thedarknet/defcon24/badge/README.md

Install Dev Env:
* go here:  http://gnuarmeclipse.github.io/ for background and step by step

Basic steps:

* Install eclipse Luna CDT (c++ env)

* add a new market place:  

name: GNU ARM Eclipse Plug-ins
URL: http://gnuarmeclipse.sourceforge.net/updates

You will see the ecplise arm plugin select it and it will install for you.

If you get complaints about missing software I found these links helpful.

* apt-get install gcc-arm-none-eabi (or something close to that)

* apt-get install openocd Or download from to configure openocd in eclipse look here: http://gnuarmeclipse.github.io/debug/openocd/ OR to download new version of openocd:  http://gnuarmeclipse.github.io/openocd/download/

Then close this repo and then import this directory into you're workspace (remeber to uncheck the option to copy all files to your workspace).

Debug configuration:
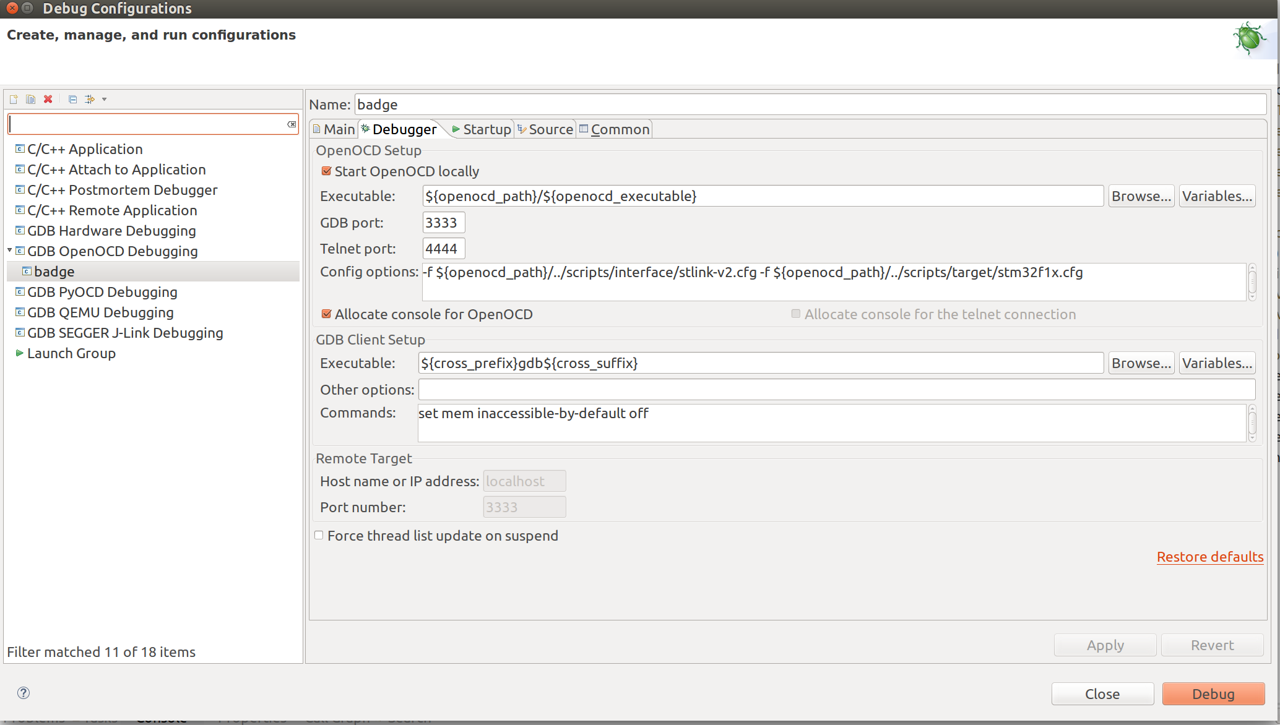
[picture p1: badge/Screenshot from 2016-06-21 22:05:16.png]
Debug Config
