thedarknet/defcon24/badge/hardware/board/README.md

# Badge hardware

	DC24-Darknet_Badge.*		The starting circuit which has both the base and the shield included
	DC24-Darknet_Badge-base.*	The final base board with puzzles in the silk screen
	DC24-Darknet_Badge-shield.*	The final shield board with puzzles in the silk screen

Note to get the boards made at OSH Park, you need to submit the individual boards base and shield. 
The combined file is strictly for the full schematic.
