thedarknet/defcon24/badge/hardware/board/DC24-Darknet_Badge.pdf

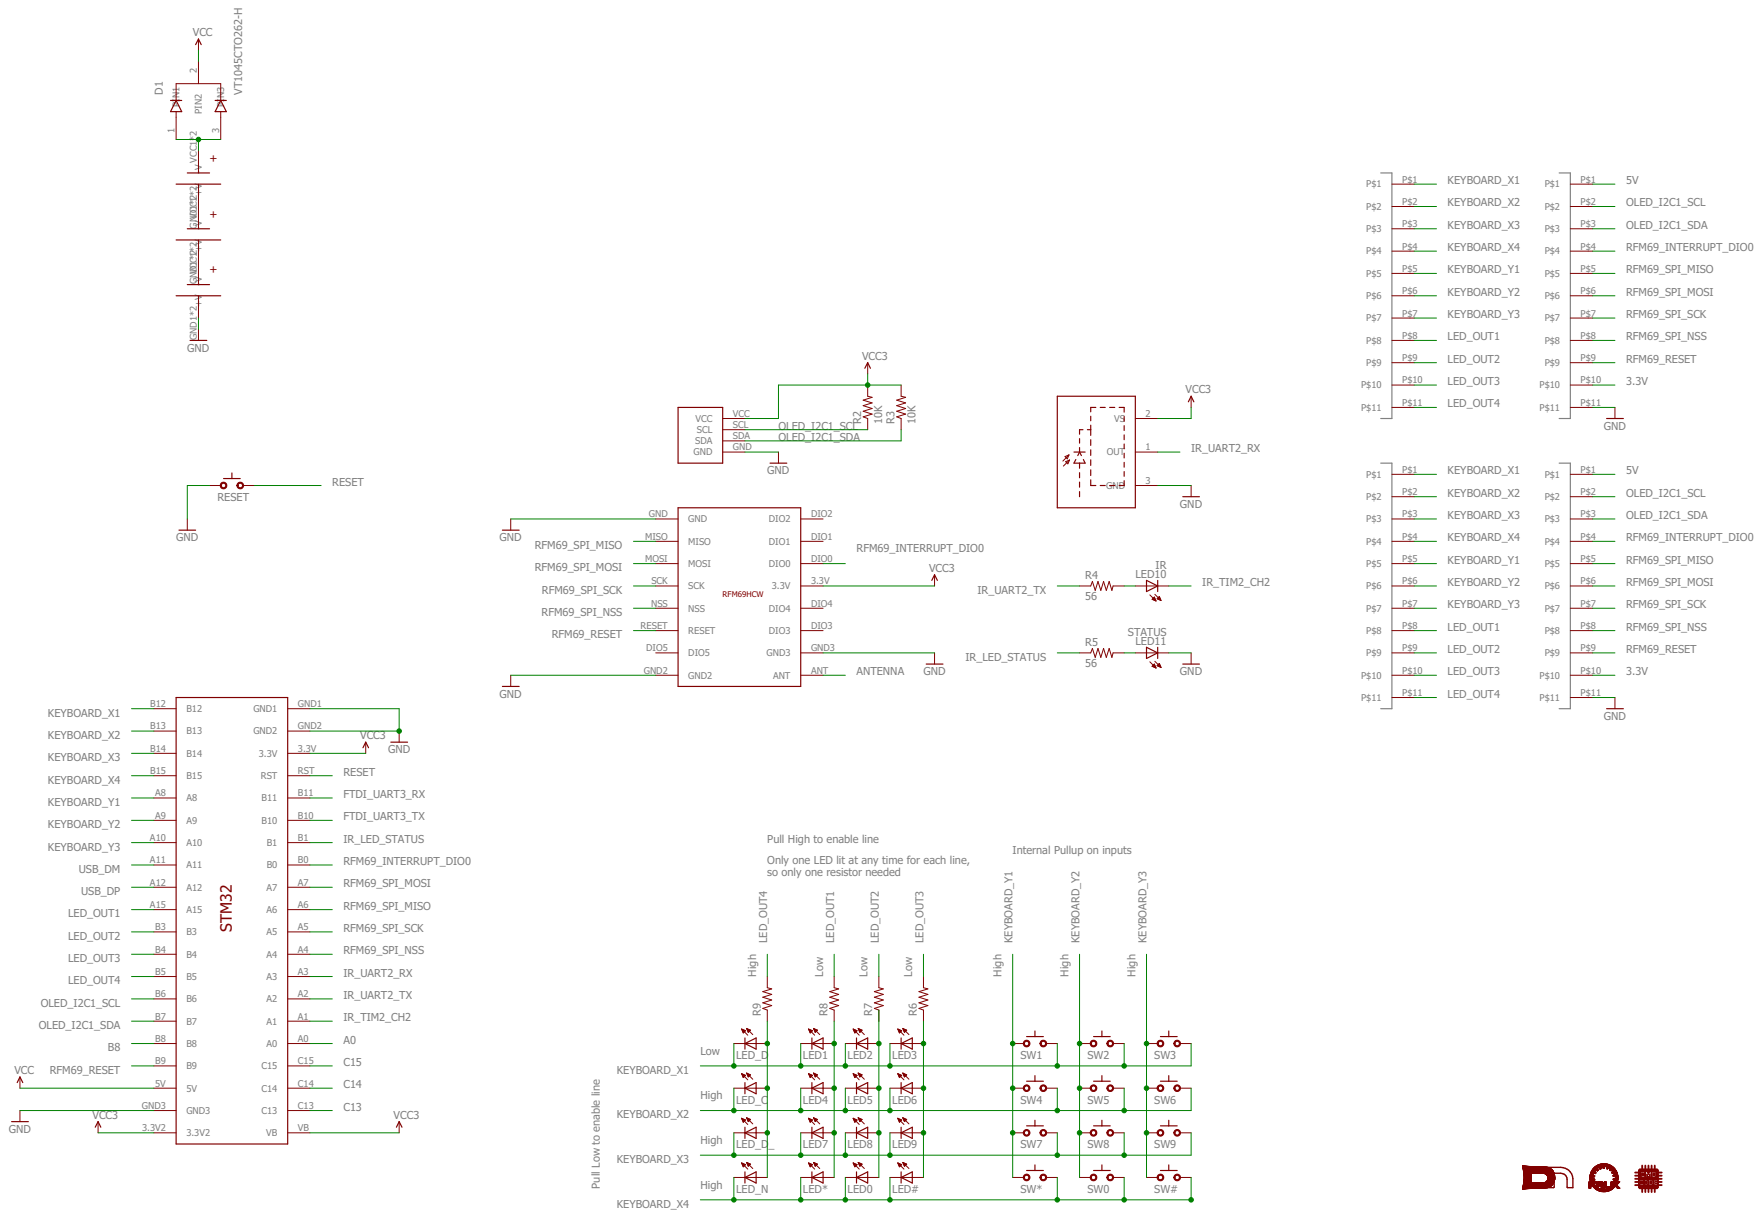
[picture p2: page 1]

Pull High to enable line Only one LED lit at any time for each line, so only one resistor needed

Internal Pullup on inputs

Pull Low to enable line
