thedarknet/defcon24/badge/hardware/board/DC24-Darknet_Badge-base.brd

## EAGLE design badge/hardware/board/DC24-Darknet_Badge-base.brd (2016-08-10)

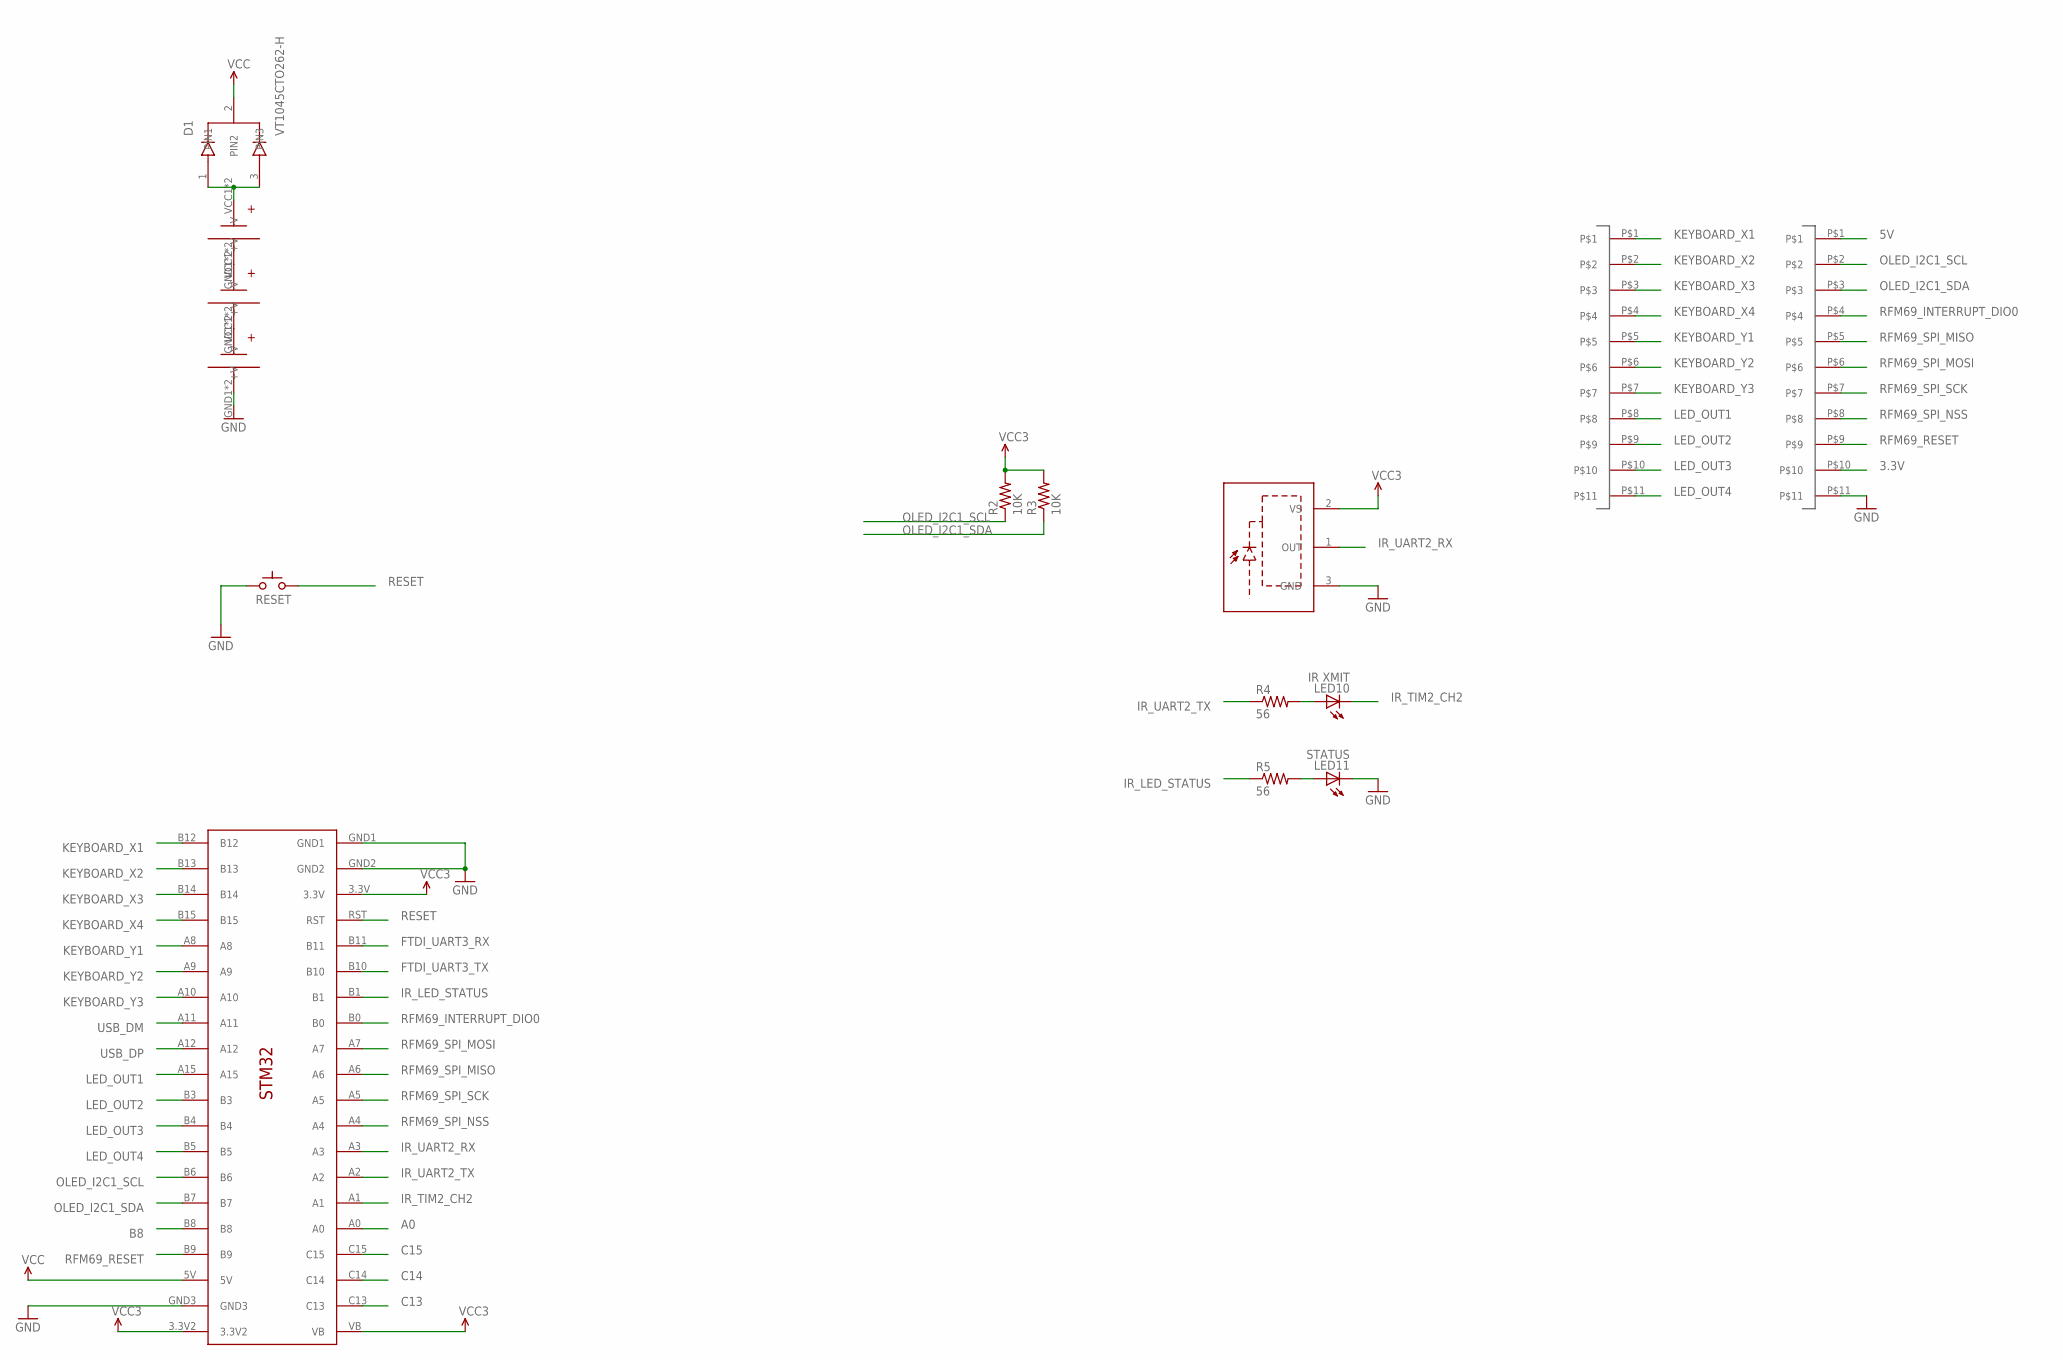
[picture p3: schematic DC24-Darknet_Badge-base.sch]

Parts:
D1: VT1045CTO262-H; TO262-H
LED10: IR XMIT; LED5MM-EDGE
LED11: STATUS; LED5MM-EDGE
R2, R3: 10K; AXIAL-0.3
R4, R5: 56; AXIAL-0.3
RESET: SWITCH_TACTILETACTILE-2PIN-NARROW; TACTILE-2PIN-NARROW
U1: SOP22; IR-MODULE
U$3, U$4, U$5: AAA_BATTERYAAA_BATTERY_CLIP; AAA_BATTERY_CLIP
U$14, U$17: HEADER_11PIN; 1X11
U$15: STM32_DEV_BOARDSTM32_DEV_BOARD; STM32_DEV_BOARD

Connections:
3.3V: R2.P$2 (2), R3.P$2 (2), U1.2 (VS), U$15.3.3V, U$15.3.3V2, U$15.VB, U$17.P$10
5V: D1.2 (PIN2), U$15.5V, U$17.P$1
A0: U$15.A0
B8: U$15.B8
C13: U$15.C13
C14: U$15.C14
C15: U$15.C15
FTDI_UART3_RX: U$15.B11
FTDI_UART3_TX: U$15.B10
GND: LED11.K (C), RESET.P$2 (C), U1.3 (GND), U$5.GND1 (-V), U$5.GND2 (-V), U$15.GND1, U$15.GND2, U$15.GND3, U$17.P$11
IR_LED_STATUS: R5.P$1 (1), U$15.B1
IR_TIM2_CH2: LED10.K (C), U$15.A1
IR_UART2_RX: U1.1 (OUT), U$15.A3
IR_UART2_TX: R4.P$1 (1), U$15.A2
KEYBOARD_X1: U$14.P$1, U$15.B12
KEYBOARD_X2: U$14.P$2, U$15.B13
KEYBOARD_X3: U$14.P$3, U$15.B14
KEYBOARD_X4: U$14.P$4, U$15.B15
KEYBOARD_Y1: U$14.P$5, U$15.A8
KEYBOARD_Y2: U$14.P$6, U$15.A9
KEYBOARD_Y3: U$14.P$7, U$15.A10
LED_OUT1: U$14.P$8, U$15.A15
LED_OUT2: U$14.P$9, U$15.B3
LED_OUT3: U$14.P$10, U$15.B4
LED_OUT4: U$14.P$11, U$15.B5
unnamed: LED10.A, R4.P$2 (2)
unnamed: LED11.A, R5.P$2 (2)
unnamed: D1.1 (PIN1), D1.3 (PIN3), U$3.VCC1 (+V), U$3.VCC2 (+V)
unnamed: U$3.GND1 (-V), U$3.GND2 (-V), U$4.VCC1 (+V), U$4.VCC2 (+V)
unnamed: U$4.GND1 (-V), U$4.GND2 (-V), U$5.VCC1 (+V), U$5.VCC2 (+V)
OLED_I2C1_SCL: R2.P$1 (1), U$15.B6, U$17.P$2
OLED_I2C1_SDA: R3.P$1 (1), U$15.B7, U$17.P$3
RESET: RESET.P$1 (A), U$15.RST
RFM69_INTERRUPT_DIO0: U$15.B0, U$17.P$4
RFM69_RESET: U$15.B9, U$17.P$9
RFM69_SPI_MISO: U$15.A6, U$17.P$5
RFM69_SPI_MOSI: U$15.A7, U$17.P$6
RFM69_SPI_NSS: U$15.A4, U$17.P$8
RFM69_SPI_SCK: U$15.A5, U$17.P$7
USB_DM: U$15.A11
USB_DP: U$15.A12

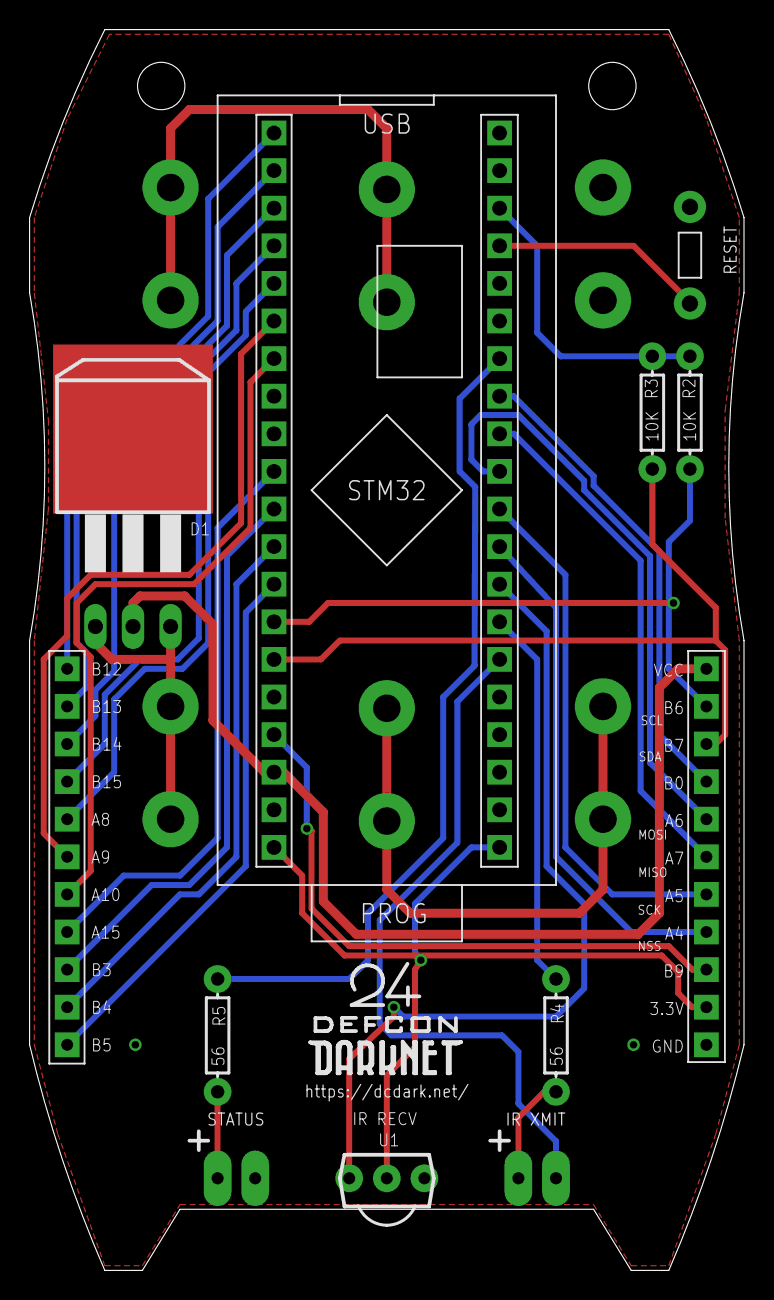
[picture p4: board DC24-Darknet_Badge-base.brd from above]

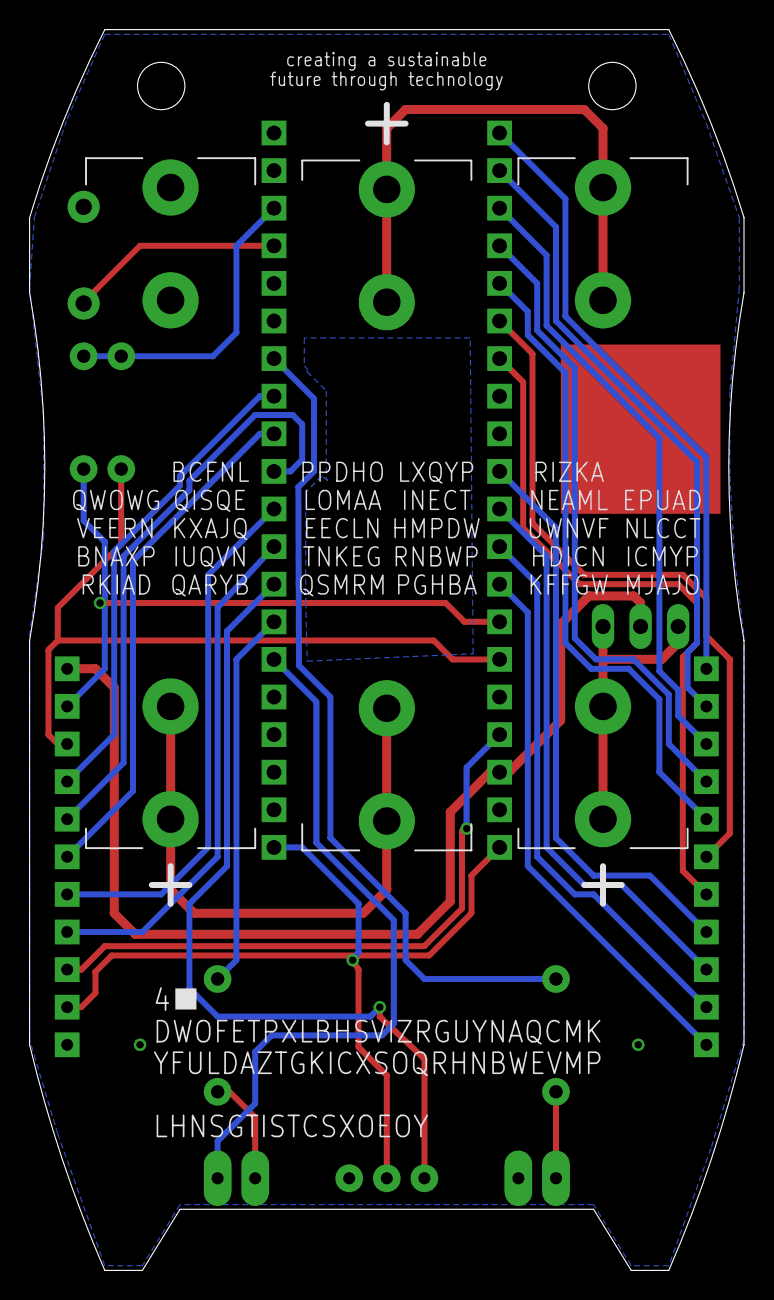
[picture p5: board DC24-Darknet_Badge-base.brd from below]

Board: 2 copper layers, 48.3 x 83.8 mm, 15 parts (3 on the bottom side), 32 nets.
