thedarknet/defcon24/badge/hardware/board/DC24-Darknet_Badge-shield.brd

## EAGLE design badge/hardware/board/DC24-Darknet_Badge-shield.brd (2016-08-08)

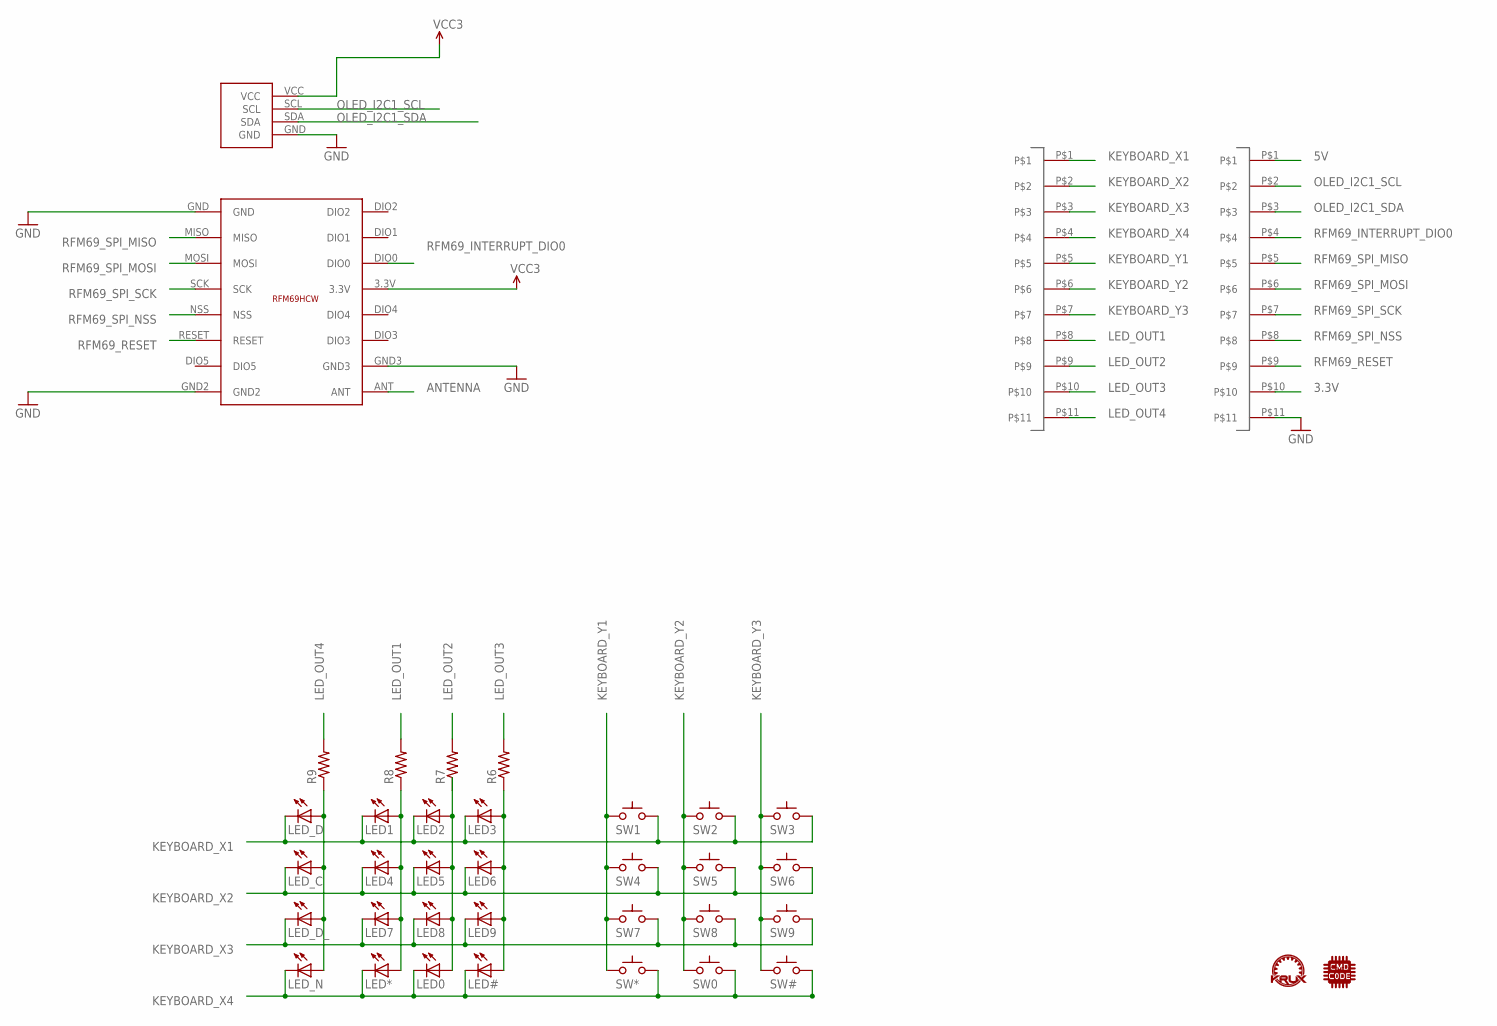
[picture p6: schematic DC24-Darknet_Badge-shield.sch]

Parts:
LED0, LED1, LED2, LED3, LED4, LED5, LED6, LED7, LED8, LED9: LEDREVERSEMOUNT; GULLWING_LED
LED#: LEDREVERSEMOUNT; GULLWING_LED
LED*: LEDREVERSEMOUNT; GULLWING_LED
LED_C: LEDREVERSEMOUNT; GULLWING_LED
LED_D: LEDREVERSEMOUNT; GULLWING_LED
LED_D_: LEDREVERSEMOUNT; GULLWING_LED
LED_N: LEDREVERSEMOUNT; GULLWING_LED
R6, R7, R8, R9: RESISTOR1206; 1206
SW0, SW1, SW2, SW3, SW4, SW5, SW6, SW7, SW8, SW9: SWITCH_TACTILETACTILE-2PIN-NARROW; TACTILE-2PIN-NARROW
SW#: SWITCH_TACTILETACTILE-2PIN-NARROW; TACTILE-2PIN-NARROW
SW*: SWITCH_TACTILETACTILE-2PIN-NARROW; TACTILE-2PIN-NARROW
U$1: I2C_0.96_OLEDOLED; I2C_0.96_OLED
U$2: RFM69HCWRFN69HCWSMD; 16PIN-PCB-SMD
U$6, U$13: HEADER_11PIN; 1X11
U$21: KRUX_LOGO
U$23: CMD_C0DE_LOGO

Connections:
3.3V: U$1.VCC, U$2.3.3V, U$13.P$10
5V: U$13.P$1
ANTENNA: U$2.ANT
GND: U$1.GND, U$2.GND, U$2.GND2, U$2.GND3, U$13.P$11
KEYBOARD_X1: LED1.C, LED2.C, LED3.C, LED_D.C, SW1.P$1 (A), SW2.P$1 (A), SW3.P$1 (A), U$6.P$1
KEYBOARD_X2: LED4.C, LED5.C, LED6.C, LED_C.C, SW4.P$1 (A), SW5.P$1 (A), SW6.P$1 (A), U$6.P$2
KEYBOARD_X3: LED7.C, LED8.C, LED9.C, LED_D_.C, SW7.P$1 (A), SW8.P$1 (A), SW9.P$1 (A), U$6.P$3
KEYBOARD_X4: LED0.C, LED#.C, LED*.C, LED_N.C, SW0.P$1 (A), SW#.P$1 (A), SW*.P$1 (A), U$6.P$4
KEYBOARD_Y1: SW1.P$2 (C), SW4.P$2 (C), SW7.P$2 (C), SW*.P$2 (C), U$6.P$5
KEYBOARD_Y2: SW0.P$2 (C), SW2.P$2 (C), SW5.P$2 (C), SW8.P$2 (C), U$6.P$6
KEYBOARD_Y3: SW3.P$2 (C), SW6.P$2 (C), SW9.P$2 (C), SW#.P$2 (C), U$6.P$7
LED_OUT1: R8.2, U$6.P$8
LED_OUT2: R7.2, U$6.P$9
LED_OUT3: R6.2, U$6.P$10
LED_OUT4: R9.2, U$6.P$11
unnamed: LED3.A, LED6.A, LED9.A, LED#.A, R6.1
unnamed: LED0.A, LED2.A, LED5.A, LED8.A, R7.1
unnamed: LED1.A, LED4.A, LED7.A, LED*.A, R8.1
unnamed: LED_C.A, LED_D.A, LED_D_.A, LED_N.A, R9.1
OLED_I2C1_SCL: U$1.SCL, U$13.P$2
OLED_I2C1_SDA: U$1.SDA, U$13.P$3
RFM69_INTERRUPT_DIO0: U$2.DIO0, U$13.P$4
RFM69_RESET: U$2.RESET, U$13.P$9
RFM69_SPI_MISO: U$2.MISO, U$13.P$5
RFM69_SPI_MOSI: U$2.MOSI, U$13.P$6
RFM69_SPI_NSS: U$2.NSS, U$13.P$8
RFM69_SPI_SCK: U$2.SCK, U$13.P$7

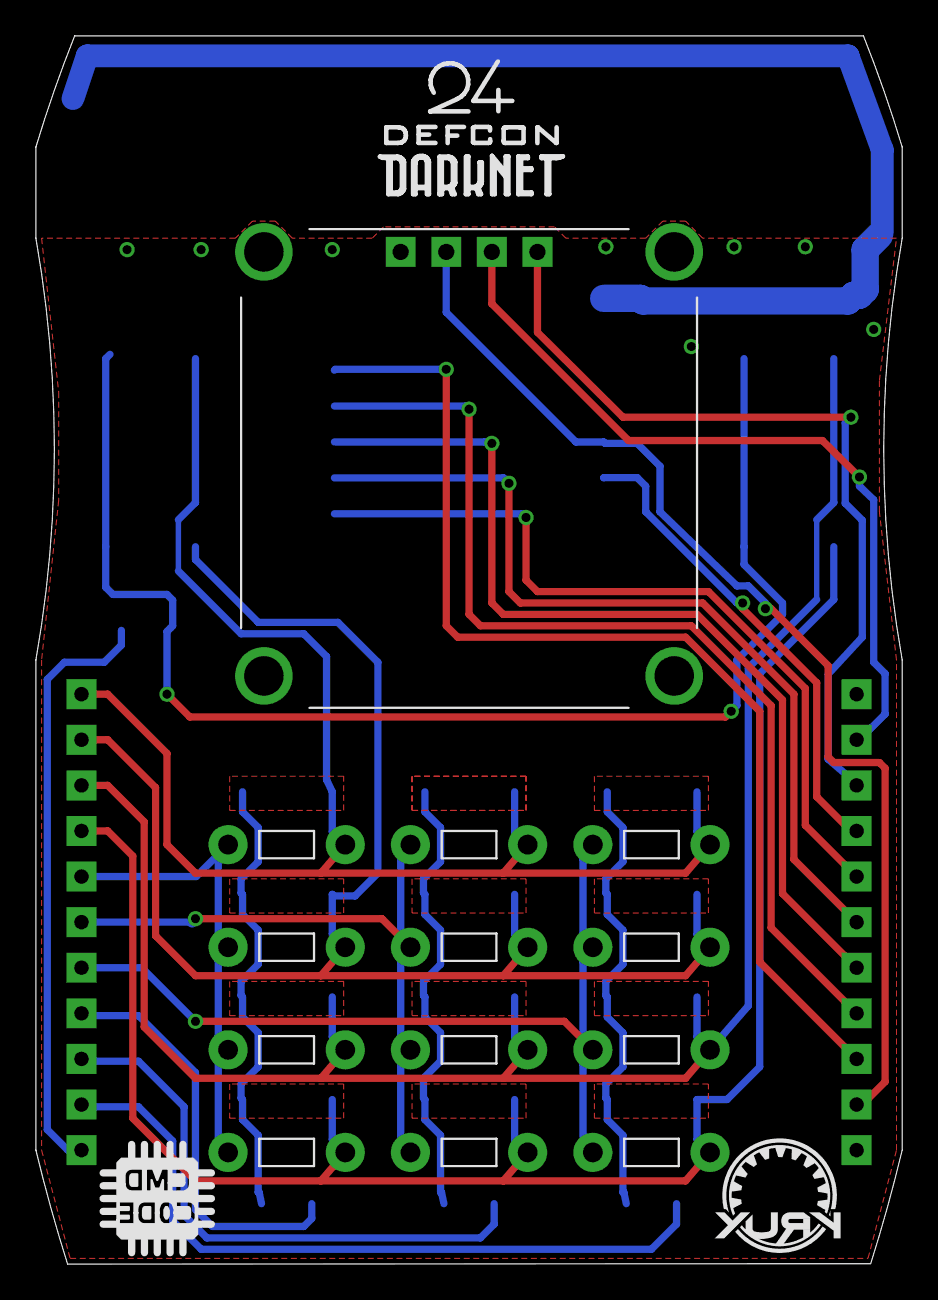
[picture p7: board DC24-Darknet_Badge-shield.brd from above]

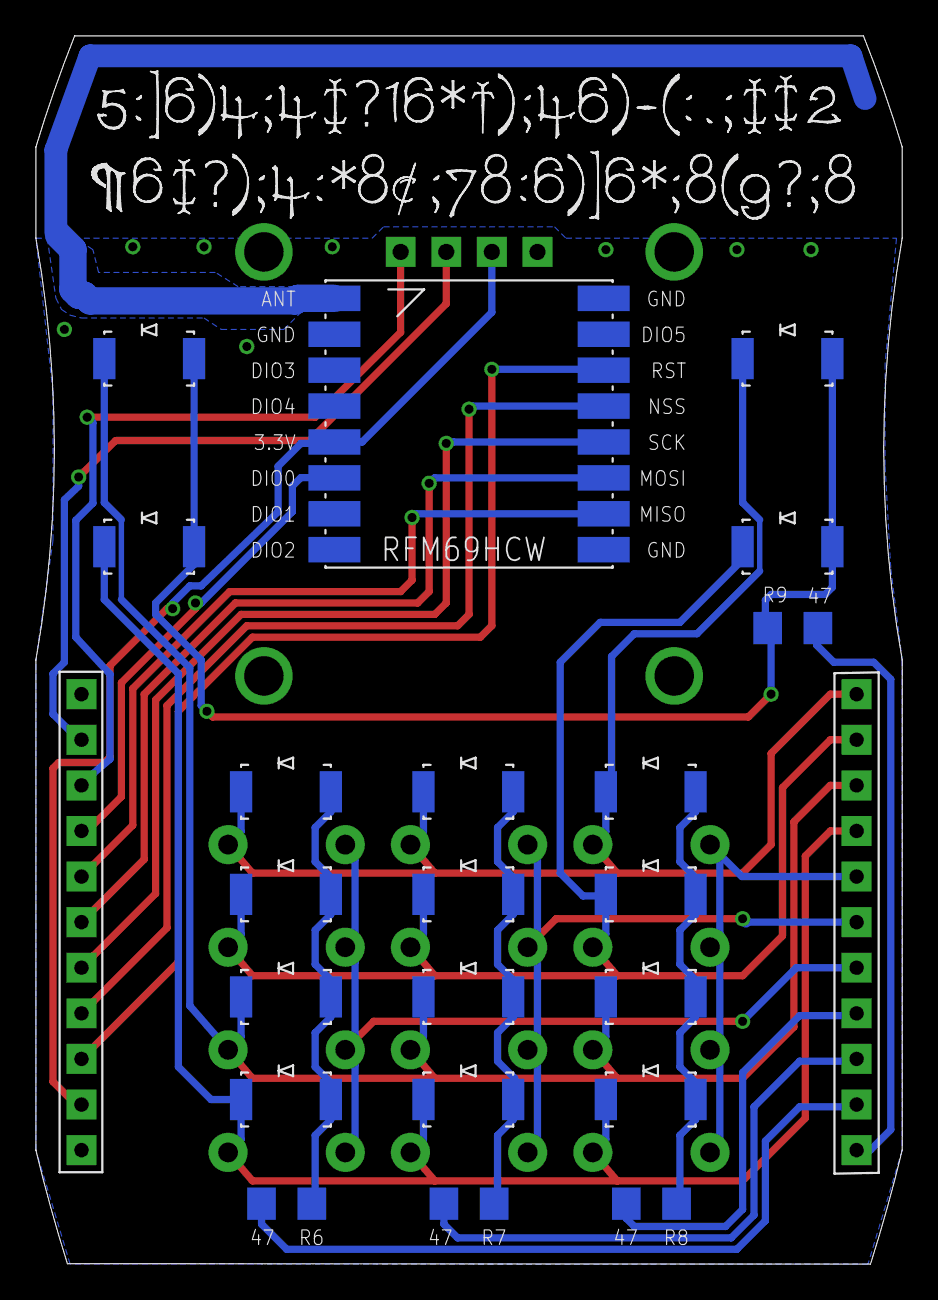
[picture p8: board DC24-Darknet_Badge-shield.brd from below]

Board: 2 copper layers, 48.3 x 68.4 mm, 38 parts (23 on the bottom side), 25 nets.
