thedarknet/defcon24/badge/hardware/board/DC24-Darknet_Badge.brd

## EAGLE design badge/hardware/board/DC24-Darknet_Badge.brd (2016-07-17)

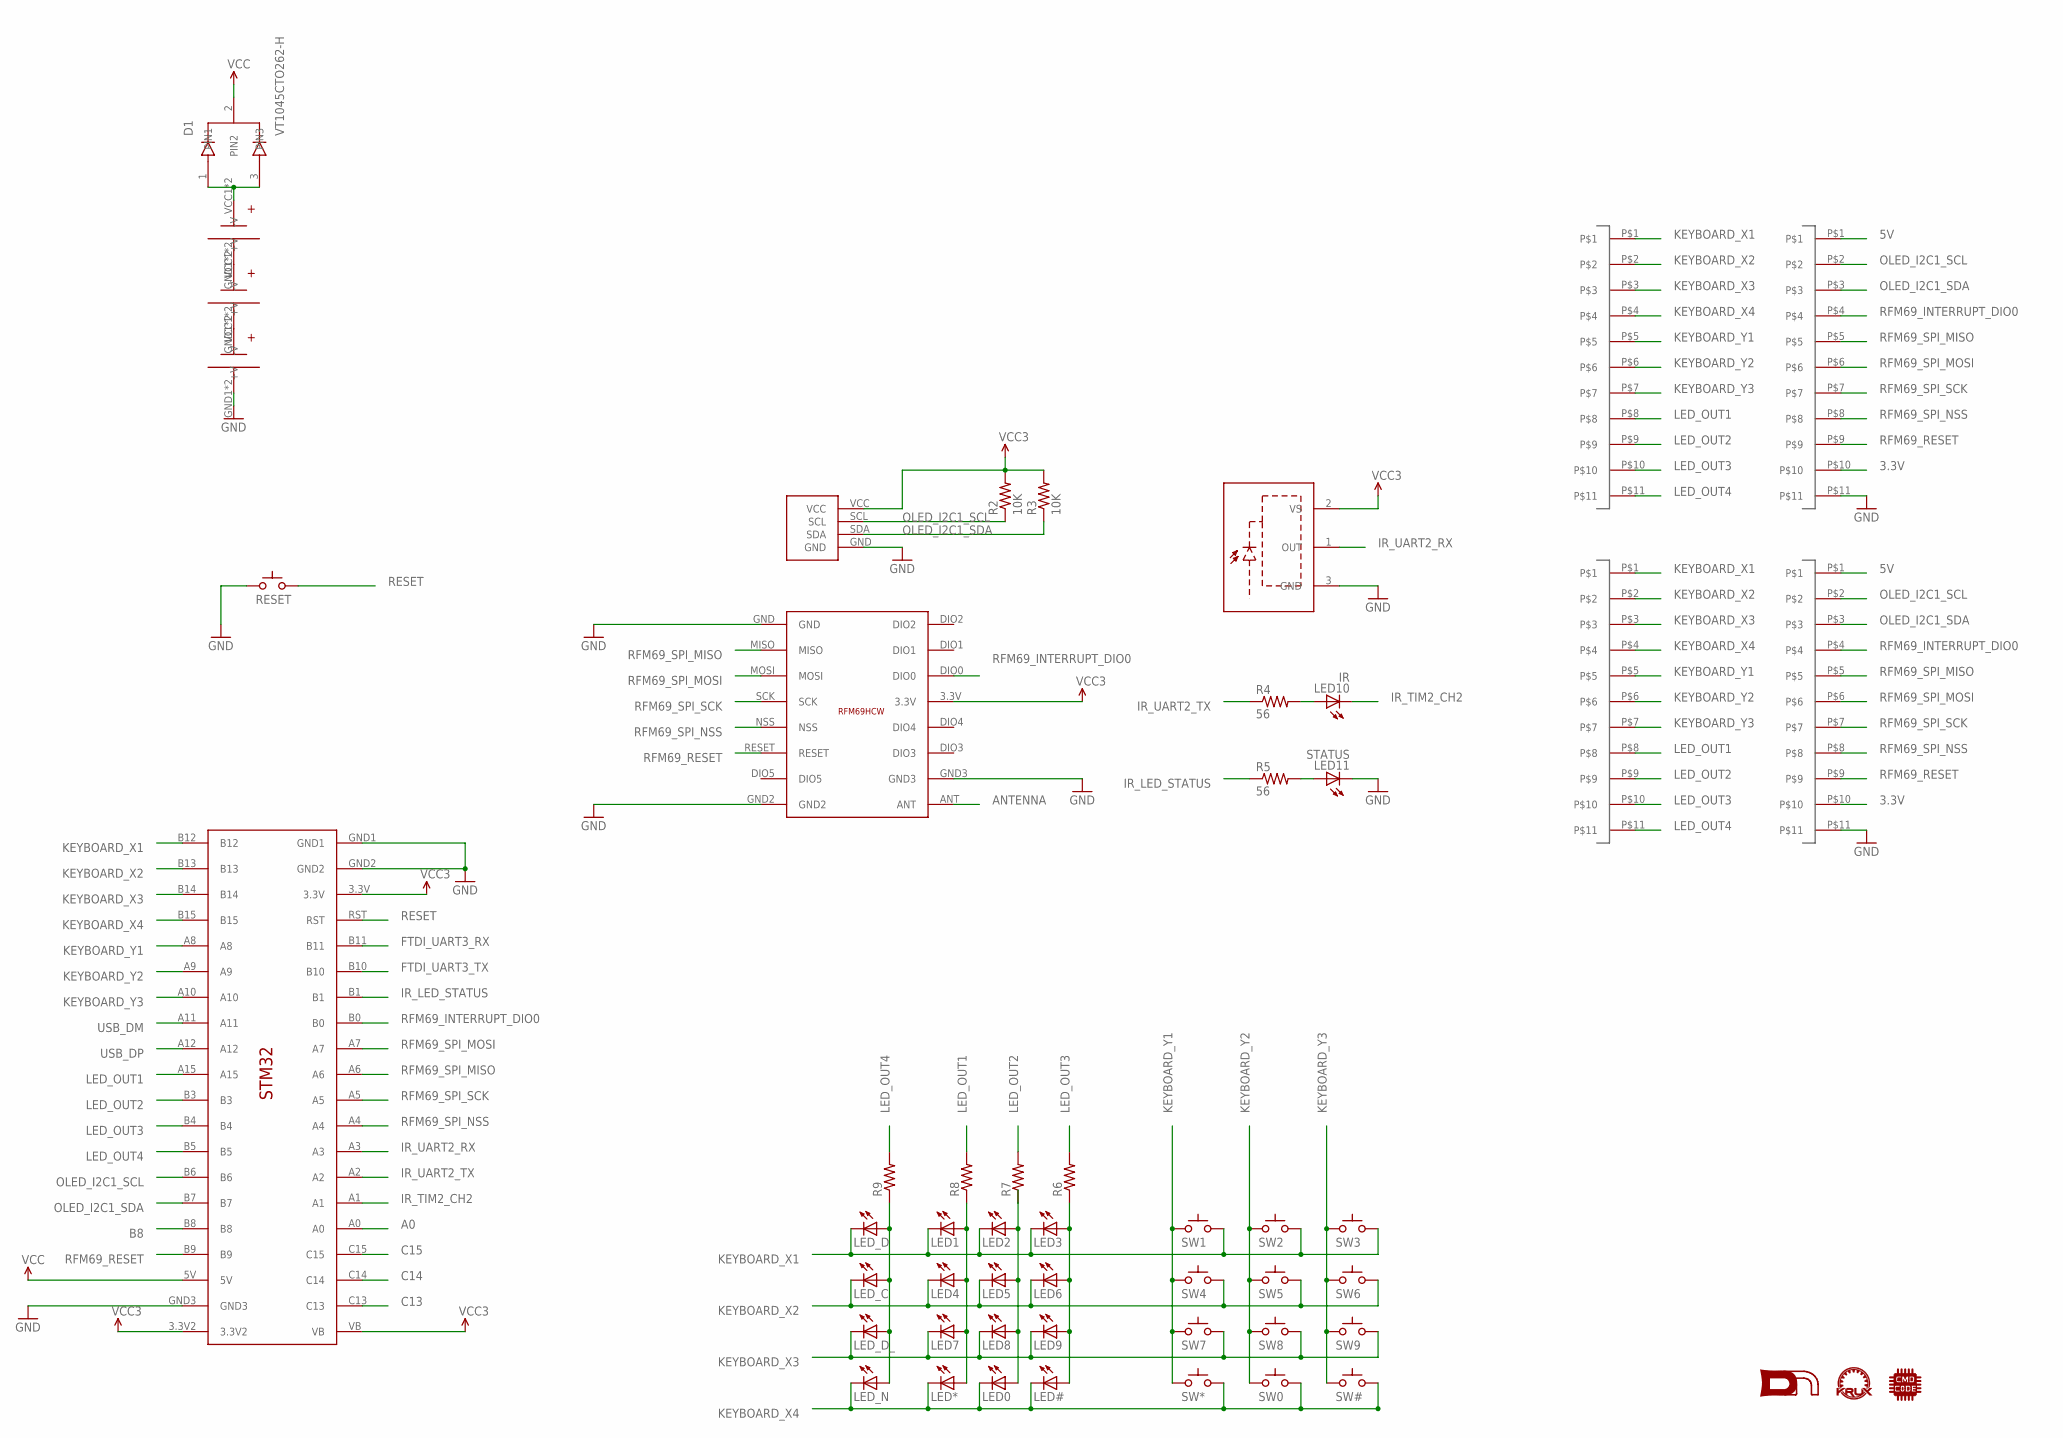
[picture p9: schematic DC24-Darknet_Badge.sch]

Parts:
D1: VT1045CTO262-H; TO262-H
LED0, LED1, LED2, LED3, LED4, LED5, LED6, LED7, LED8, LED9: LEDREVERSEMOUNT; GULLWING_LED
LED10: IR; LED5MM-EDGE
LED11: STATUS; LED5MM-EDGE
LED#: LEDREVERSEMOUNT; GULLWING_LED
LED*: LEDREVERSEMOUNT; GULLWING_LED
LED_C: LEDREVERSEMOUNT; GULLWING_LED
LED_D: LEDREVERSEMOUNT; GULLWING_LED
LED_D_: LEDREVERSEMOUNT; GULLWING_LED
LED_N: LEDREVERSEMOUNT; GULLWING_LED
Q1: SOP22; IR-MODULE
R2, R3: 10K; AXIAL-0.3
R4, R5: 56; AXIAL-0.3
R6, R7, R8, R9: RESISTOR1206; 1206
RESET: SWITCH_TACTILETACTILE-2PIN-NARROW; TACTILE-2PIN-NARROW
SW0, SW1, SW2, SW3, SW4, SW5, SW6, SW7, SW8, SW9: SWITCH_TACTILETACTILE-2PIN-NARROW; TACTILE-2PIN-NARROW
SW#: SWITCH_TACTILETACTILE-2PIN-NARROW; TACTILE-2PIN-NARROW
SW*: SWITCH_TACTILETACTILE-2PIN-NARROW; TACTILE-2PIN-NARROW
U$1: I2C_0.96_OLEDOLED; I2C_0.96_OLED
U$2: RFM69HCWRFN69HCWSMD; 16PIN-PCB-SMD
U$3, U$4, U$5: AAA_BATTERYAAA_BATTERY_CLIP; AAA_BATTERY_CLIP
U$6, U$13, U$14, U$17: HEADER_11PIN; 1X11
U$15: STM32_DEV_BOARDSTM32_DEV_BOARD; STM32_DEV_BOARD
U$21: KRUX_LOGO
U$22: DN_LOGO
U$23: CMD_C0DE_LOGO

Connections:
3.3V: Q1.2 (VS), R2.P$2 (2), R3.P$2 (2), U$1.VCC, U$2.3.3V, U$13.P$10, U$15.3.3V, U$15.3.3V2, U$15.VB, U$17.P$10
5V: D1.2 (PIN2), U$13.P$1, U$15.5V, U$17.P$1
A0: U$15.A0
ANTENNA: U$2.ANT
B8: U$15.B8
C13: U$15.C13
C14: U$15.C14
C15: U$15.C15
FTDI_UART3_RX: U$15.B11
FTDI_UART3_TX: U$15.B10
GND: LED11.K (C), Q1.3 (GND), RESET.P$2 (C), U$1.GND, U$2.GND, U$2.GND2, U$2.GND3, U$5.GND1 (-V), U$5.GND2 (-V), U$13.P$11, U$15.GND1, U$15.GND2, U$15.GND3, U$17.P$11
IR_LED_STATUS: R5.P$1 (1), U$15.B1
IR_TIM2_CH2: LED10.K (C), U$15.A1
IR_UART2_RX: Q1.1 (OUT), U$15.A3
IR_UART2_TX: R4.P$1 (1), U$15.A2
KEYBOARD_X1: LED1.C, LED2.C, LED3.C, LED_D.C, SW1.P$1 (A), SW2.P$1 (A), SW3.P$1 (A), U$6.P$1, U$14.P$1, U$15.B12
KEYBOARD_X2: LED4.C, LED5.C, LED6.C, LED_C.C, SW4.P$1 (A), SW5.P$1 (A), SW6.P$1 (A), U$6.P$2, U$14.P$2, U$15.B13
KEYBOARD_X3: LED7.C, LED8.C, LED9.C, LED_D_.C, SW7.P$1 (A), SW8.P$1 (A), SW9.P$1 (A), U$6.P$3, U$14.P$3, U$15.B14
KEYBOARD_X4: LED0.C, LED#.C, LED*.C, LED_N.C, SW0.P$1 (A), SW#.P$1 (A), SW*.P$1 (A), U$6.P$4, U$14.P$4, U$15.B15
KEYBOARD_Y1: SW1.P$2 (C), SW4.P$2 (C), SW7.P$2 (C), SW*.P$2 (C), U$6.P$5, U$14.P$5, U$15.A8
KEYBOARD_Y2: SW0.P$2 (C), SW2.P$2 (C), SW5.P$2 (C), SW8.P$2 (C), U$6.P$6, U$14.P$6, U$15.A9
KEYBOARD_Y3: SW3.P$2 (C), SW6.P$2 (C), SW9.P$2 (C), SW#.P$2 (C), U$6.P$7, U$14.P$7, U$15.A10
LED_OUT1: R8.2, U$6.P$8, U$14.P$8, U$15.A15
LED_OUT2: R7.2, U$6.P$9, U$14.P$9, U$15.B3
LED_OUT3: R6.2, U$6.P$10, U$14.P$10, U$15.B4
LED_OUT4: R9.2, U$6.P$11, U$14.P$11, U$15.B5
unnamed: LED10.A, R4.P$2 (2)
unnamed: LED11.A, R5.P$2 (2)
unnamed: D1.1 (PIN1), D1.3 (PIN3), U$3.VCC1 (+V), U$3.VCC2 (+V)
unnamed: LED3.A, LED6.A, LED9.A, LED#.A, R6.1
unnamed: LED0.A, LED2.A, LED5.A, LED8.A, R7.1
unnamed: LED1.A, LED4.A, LED7.A, LED*.A, R8.1
unnamed: LED_C.A, LED_D.A, LED_D_.A, LED_N.A, R9.1
unnamed: U$3.GND1 (-V), U$3.GND2 (-V), U$4.VCC1 (+V), U$4.VCC2 (+V)
unnamed: U$4.GND1 (-V), U$4.GND2 (-V), U$5.VCC1 (+V), U$5.VCC2 (+V)
OLED_I2C1_SCL: R2.P$1 (1), U$1.SCL, U$13.P$2, U$15.B6, U$17.P$2
OLED_I2C1_SDA: R3.P$1 (1), U$1.SDA, U$13.P$3, U$15.B7, U$17.P$3
RESET: RESET.P$1 (A), U$15.RST
RFM69_INTERRUPT_DIO0: U$2.DIO0, U$13.P$4, U$15.B0, U$17.P$4
RFM69_RESET: U$2.RESET, U$13.P$9, U$15.B9, U$17.P$9
RFM69_SPI_MISO: U$2.MISO, U$13.P$5, U$15.A6, U$17.P$5
RFM69_SPI_MOSI: U$2.MOSI, U$13.P$6, U$15.A7, U$17.P$6
RFM69_SPI_NSS: U$2.NSS, U$13.P$8, U$15.A4, U$17.P$8
RFM69_SPI_SCK: U$2.SCK, U$13.P$7, U$15.A5, U$17.P$7
USB_DM: U$15.A11
USB_DP: U$15.A12

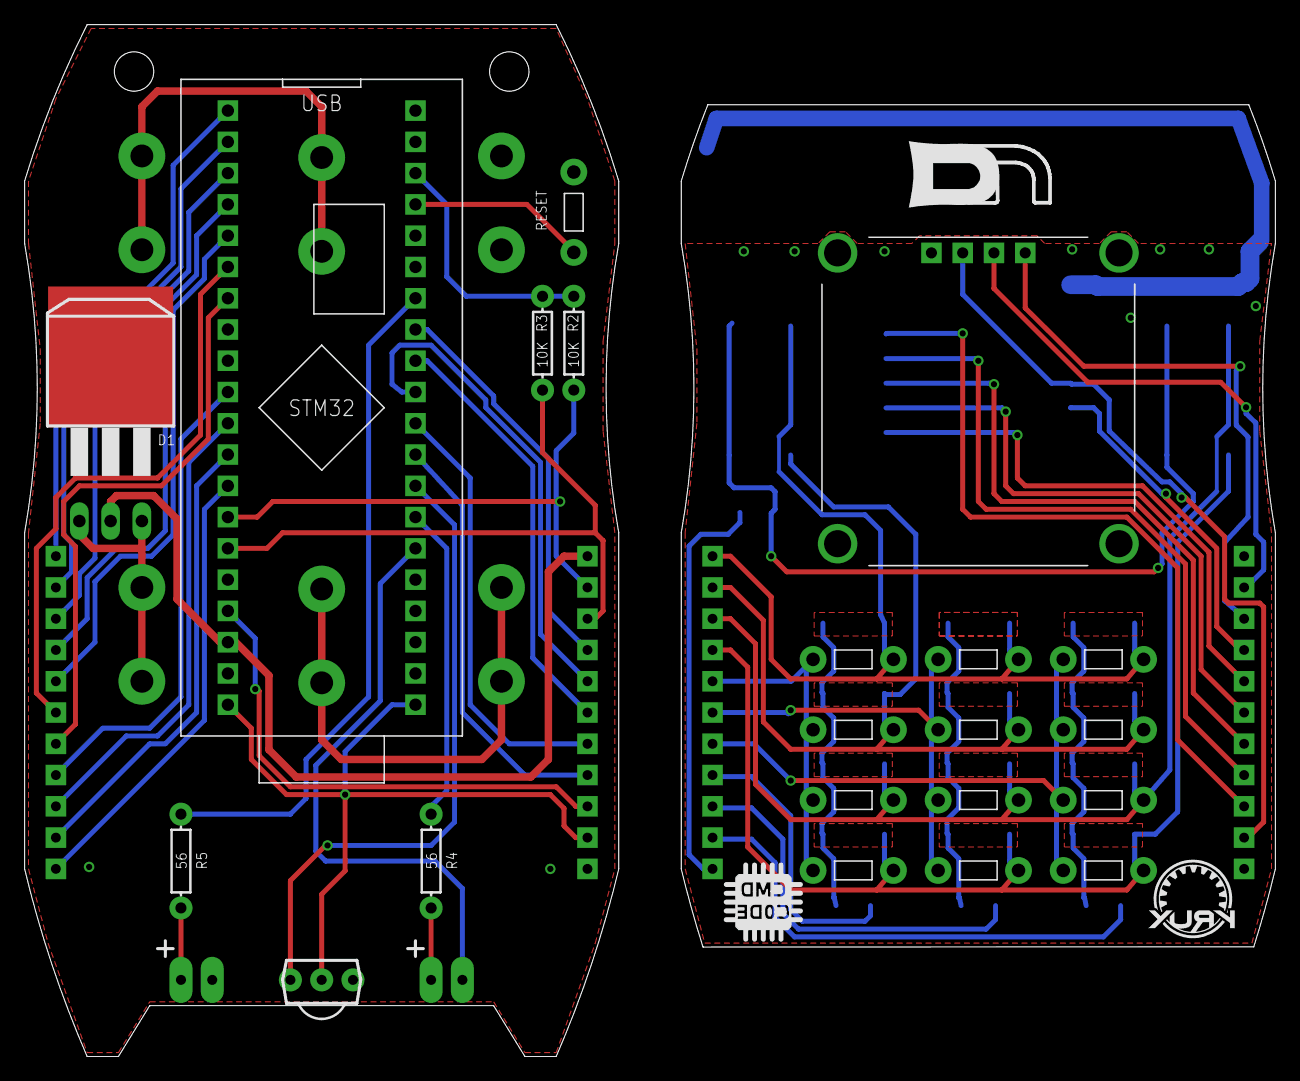
[picture p10: board DC24-Darknet_Badge.brd from above]

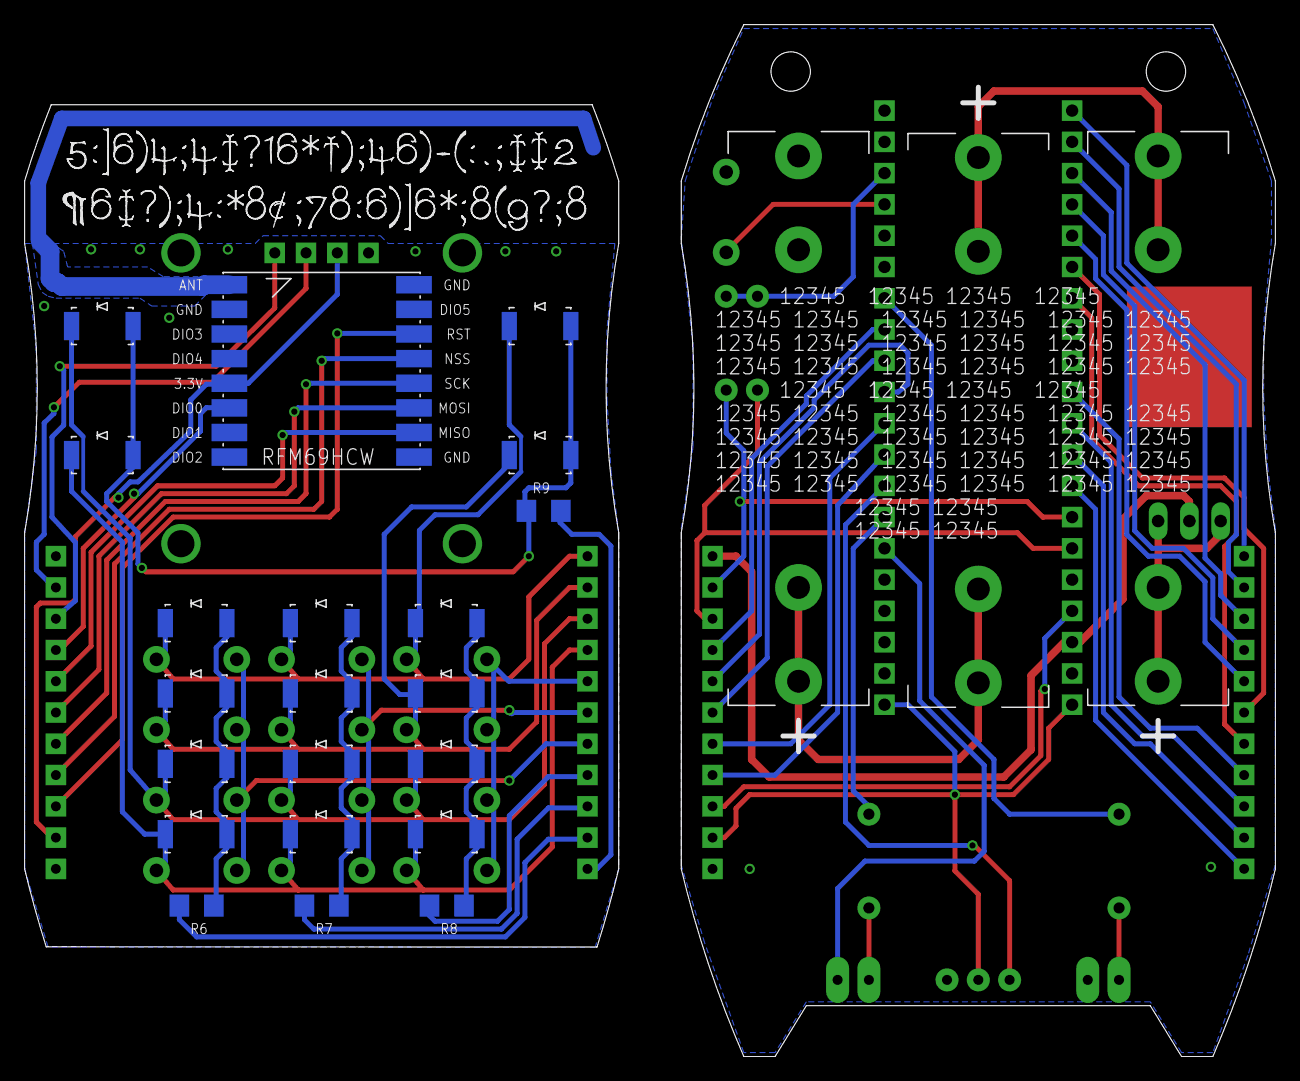
[picture p11: board DC24-Darknet_Badge.brd from below]

Board: 2 copper layers, 101.6 x 83.8 mm, 54 parts (26 on the bottom side), 36 nets.
