thedarknet/defcon24/badge/badge-firmware-eclipse/src/main.cpp

/**
 ******************************************************************************
 * File Name          : main.c
 * Description        : Main program body
 ******************************************************************************
 *
 * COPYRIGHT(c) 2016 STMicroelectronics
 *
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
 ******************************************************************************
 */
/* Includes ------------------------------------------------------------------*/
#include "stm32f1xx_hal.h"
#include "dma.h"
#include "i2c.h"
#include "spi.h"
#include "tim.h"
#include "usart.h"
#include "gpio.h"
#include "Badge/menus/ir.h"
#include <KeyStore.h>

/* USER CODE BEGIN Includes */
#include <badge.h>
/* USER CODE END Includes */


/* USER CODE BEGIN PV */

/* USER CODE END PV */

void SystemClock_Config(void);

/* USER CODE BEGIN PFP */

/* USER CODE END PFP */

int main(void) {

	/* MCU Configuration----------------------------------------------------------*/

	/* Reset of all peripherals, Initializes the Flash interface and the Systick. */
	HAL_Init();

	/* Configure the system clock */
	SystemClock_Config();

	/* Initialize all configured peripherals */
	MX_GPIO_Init();
	MX_DMA_Init();
	MX_I2C1_Init();
	MX_SPI1_Init();
	MX_TIM2_Init();
	//MX_USART2_UART_Init();
	MX_USART3_UART_Init();
	IRInit();
	//MX_USB_DEVICE_Init();

	/* USER CODE BEGIN 2 */
	const uint32_t retStart = startBadge();
	if ((retStart & COMPONENTS_ITEMS::OLED) == 0) {
		// oled did not initialize
		//so we'll let the agent know via LED
		while (1) {
			HAL_GPIO_WritePin(LED_IR_STATUS_GPIO_Port, LED_IR_STATUS_Pin, GPIO_PIN_SET);
			delay(200);
			HAL_GPIO_WritePin(LED_IR_STATUS_GPIO_Port, LED_IR_STATUS_Pin, GPIO_PIN_RESET);
			delay(400);
		}
	}
#if 0
	//this is broken;
	const char *scratch = "ABCDEFGHIJKLMNOPQRSTUVWXYZ";
	uint8_t key[ContactStore::PUBLIC_KEY_COMPRESSED_LENGTH] = {0};
	uint8_t sigtmp[48] = {0};
	for(uint16_t i=1;i<27;i++) {
		char buf[ContactStore::AGENT_NAME_LENGTH] = {'\0'};
		buf[0] = scratch[i%25];
		getContactStore().addContact(i,&buf[0],&key[0],&sigtmp[0]);
	}
#endif
	/* USER CODE END 2 */

	/* Infinite loop */
	/* USER CODE BEGIN WHILE */
	while (1) {
		/* USER CODE END WHILE */
		loopBadge();
		/* USER CODE BEGIN 3 */

	}
	/* USER CODE END 3 */

}

void SystemClock_Config(void) {

	RCC_OscInitTypeDef RCC_OscInitStruct;
	RCC_ClkInitTypeDef RCC_ClkInitStruct;
	RCC_PeriphCLKInitTypeDef PeriphClkInit;

	RCC_OscInitStruct.OscillatorType = RCC_OSCILLATORTYPE_HSE;
	RCC_OscInitStruct.HSEState = RCC_HSE_ON;
	RCC_OscInitStruct.HSEPredivValue = RCC_HSE_PREDIV_DIV1;
	RCC_OscInitStruct.PLL.PLLState = RCC_PLL_ON;
	RCC_OscInitStruct.PLL.PLLSource = RCC_PLLSOURCE_HSE;
	RCC_OscInitStruct.PLL.PLLMUL = RCC_PLL_MUL6;
	HAL_RCC_OscConfig(&RCC_OscInitStruct);

	RCC_ClkInitStruct.ClockType = RCC_CLOCKTYPE_HCLK | RCC_CLOCKTYPE_SYSCLK | RCC_CLOCKTYPE_PCLK1 | RCC_CLOCKTYPE_PCLK2;
	RCC_ClkInitStruct.SYSCLKSource = RCC_SYSCLKSOURCE_PLLCLK;
	RCC_ClkInitStruct.AHBCLKDivider = RCC_SYSCLK_DIV1;
	RCC_ClkInitStruct.APB1CLKDivider = RCC_HCLK_DIV2;
	RCC_ClkInitStruct.APB2CLKDivider = RCC_HCLK_DIV1;
	HAL_RCC_ClockConfig(&RCC_ClkInitStruct, FLASH_LATENCY_1);

	PeriphClkInit.PeriphClockSelection = RCC_PERIPHCLK_USB;
	PeriphClkInit.UsbClockSelection = RCC_USBCLKSOURCE_PLL;
	HAL_RCCEx_PeriphCLKConfig(&PeriphClkInit);

	HAL_SYSTICK_Config(HAL_RCC_GetHCLKFreq() / 1000);

	HAL_SYSTICK_CLKSourceConfig(SYSTICK_CLKSOURCE_HCLK);

	/* SysTick_IRQn interrupt configuration */
	//HAL_NVIC_SetPriority(SysTick_IRQn, 0, 0);
  	HAL_NVIC_SetPriority((IRQn_Type)SysTick_IRQn, uint32_t(0), uint32_t(0));
}

#ifdef USE_FULL_ASSERT

/**
 * @brief Reports the name of the source file and the source line number
 * where the assert_param error has occurred.
 * @param file: pointer to the source file name
 * @param line: assert_param error line source number
 * @retval None
 */
void assert_failed(uint8_t* file, uint32_t line) {
	/* USER CODE BEGIN 6 */
	file;
	line;
	/* User can add his own implementation to report the file name and line number,
	 ex: printf("Wrong parameters value: file %s on line %d\r\n", file, line) */
	/* USER CODE END 6 */

}

#endif

/**
 * @}
 */

/**
 * @}
 */

/************************ (C) COPYRIGHT STMicroelectronics *****END OF FILE****/
