thedarknet/defcon24/badge/badge-firmware-eclipse/badge-firmware.ioc

Mcu.UserName=STM32F103C8Tx
PA1.GPIO_Label=IR_TIM2_CH2
PA1.Signal=S_TIM2_CH2
PA10.GPIO_Label=KEYBOARD_Y3
PA10.Signal=GPIO_Input
PA11.Signal=USB_DM
PA12.Signal=USB_DP
PA13.Signal=SYS_JTMS-SWDIO
PA14.Signal=SYS_JTCK-SWCLK
PA15.GPIO_Label=LED_OUT1
PA15.Signal=GPIO_Output
PA2.GPIO_Label=IR_UART2_TX
PA2.Signal=USART2_TX
PA3.GPIO_Label=IR_UART2_RX
PA3.Signal=USART2_RX
PA4.GPIO_Label=RFM69_SPI_NSS
PA4.Signal=SPI1_NSS
PA5.GPIO_Label=RFM69_SPI1_SCK
PA5.Signal=SPI1_SCK
PA6.GPIO_Label=RFM69_SPI_MISO
PA6.Signal=SPI1_MISO
PA7.GPIO_Label=RFM69_SPI_MOSI
PA7.Signal=SPI1_MOSI
PA8.GPIO_Label=KEYBOARD_Y1
PA8.Signal=GPIO_Input
PA9.GPIO_Label=KEYBOARD_Y2
PA9.Signal=GPIO_Input
PB0.GPIO_Label=RFM69_Interrupt_DIO0
PB0.Signal=GPXTI0
PB1.GPIO_Label=LED_IR_STATUS
PB1.Signal=GPIO_Output
PB10.GPIO_Label=FTDI_USART3_TX
PB10.Signal=USART3_TX
PB11.GPIO_Label=FTDI_UXART3_RX
PB11.Signal=USART3_RX
PB12.GPIO_Label=KEYBOARD_X1
PB12.Signal=GPIO_Output
PB13.GPIO_Label=KEYBOARD_X2
PB13.Signal=GPIO_Output
PB14.GPIO_Label=KEYBOARD_X3
PB14.Signal=GPIO_Output
PB15.GPIO_Label=KEYBOARD_X4
PB15.Signal=GPIO_Output
PB3.GPIO_Label=LED_OUT2
PB3.Signal=GPIO_Output
PB4.GPIO_Label=LED_OUT3
PB4.Signal=GPIO_Output
PB5.GPIO_Label=LED_OUT4
PB5.Signal=GPIO_Output
PB6.GPIO_Label=OLED_I2C1_SCL
PB6.Signal=I2C1_SCL
PB7.GPIO_Label=OLED_I2C1_SDA
PB7.Signal=I2C1_SDA
PD0-OSC_IN.Signal=RCC_OSC_IN
PD1-OSC_OUT.Signal=RCC_OSC_OUT
