thedarknet/defcon24/badge/badge-firmware-eclipse/src/Badge/menus/SendMsgState.cpp

#include "SendMsgState.h"
#include <RFM69.h>

SendMsgState::SendMsgState() :
		StateBase(), RadioID(0), AgentName(0), MsgBuffer(), InternalState(TYPE_MESSAGE) {

}
SendMsgState::~SendMsgState() {

}
void SendMsgState::setContactToMessage(const uint16_t radioID, const char *agentName) {
	RadioID = radioID;
	AgentName = agentName;
}

ErrorType SendMsgState::onInit() {
	if (shouldReset()) {
		memset(&MsgBuffer[0], 0, sizeof(MsgBuffer));
		getKeyboardContext().init(&MsgBuffer[0], sizeof(MsgBuffer));
	} else {
		clearState(DONT_RESET);
	}
	InternalState = TYPE_MESSAGE;
	return ErrorType();
}

ReturnStateContext SendMsgState::onRun(QKeyboard &kb) {
	StateBase *nextState = this;
	switch (InternalState) {
	case TYPE_MESSAGE: {
		gui_lable_multiline("Send Message: ", 0, 10, 128, 64, 0, 0);
		gui_lable_multiline(&MsgBuffer[0], 0, 20, 128, 64, 0, 0);
		//keyboard entry
		kb.updateContext(getKeyboardContext());
		uint8_t pin = kb.getLastKeyReleased();
		if (pin == 11) { //return has been pushed
			getKeyboardContext().finalize();
			InternalState = INTERNAL_STATE::CONFIRM_SEND;
		}
	}
		break;
	case CONFIRM_SEND: {
		gui_lable_multiline("Send by pressing return.", 0, 10, 128, 64, 0, 0);
		gui_lable_multiline("Cancel by pressing #.", 0, 30, 128, 64, 0, 0);
		//gui_lable_multiline(&MsgBuffer[0], 0, 30, 128, 64, 0, 0);
		uint8_t pin = kb.getLastKeyReleased();
		if (pin == 9) {
			InternalState = TYPE_MESSAGE;
		} else if (pin == 11) {
			InternalState = SENDING;
		}
	}
		break;
	case SENDING: {
		static char buf[32];
		sprintf(&buf[0], "Sending Message to: %s", AgentName);
		gui_lable_multiline(&buf[0], 0, 10, 128, 64, 0, 0);
#ifdef DONT_USE_ACK
		getRadio().send(RadioID, &MsgBuffer[0], strlen(&MsgBuffer[0]), false);
		nextState = StateFactory::getDisplayMessageState(StateFactory::getMenuState(), "Message Sent!", 5000);
#else
		//TODO get ack working
		if (getRadio().sendWithRetry(RadioID, &MsgBuffer[0], strlen(&MsgBuffer[0]), 1, 400)) {
			nextState = StateFactory::getDisplayMessageState(StateFactory::getMenuState(), "Message Sent Successfully!",
					5000);
		} else {
			static char ResultBuf[64];
			sprintf(&ResultBuf[0],"Failed to send: \nAddress: %d\n N: %s", RadioID,AgentName);
			nextState = StateFactory::getDisplayMessageState(StateFactory::getSendMessageState(),
					&ResultBuf[0], 8000);
			setState(DONT_RESET);
		}
#endif
	}
		break;
	}
	return ReturnStateContext(nextState);
}

ErrorType SendMsgState::onShutdown() {
	if (shouldReset()) {
		RadioID = 0;
		AgentName = 0;
	}
	return ErrorType();
}
