thedarknet/defcon24/badge/badge-firmware-eclipse/src/Badge/menus.cpp

#include "stm32f1xx_hal.h"
#include "menus.h"
#include <tim.h>
#include <RFM69.h>
#include <uECC.h>
#include <sha256.h>
#include "menus/irmenu.h"
#include "menus/GameOfLife.h"
#include "menus/MessageState.h"
#include "menus/AddressState.h"
#include "menus/EnigmaState.h"
#include "menus/SendMsgState.h"

StateBase::StateBase() :
		StateData(0), StateStartTime(0) {
}

ReturnStateContext StateBase::run(QKeyboard &kb) {
	ReturnStateContext sr(this);
	if (!hasBeenInitialized()) {
		ErrorType et = init();
		if (!et.ok()) {
			sr.NextMenuToRun = StateFactory::getDisplayMessageState(StateFactory::getMenuState(), et.getMessage(),
					10000);
		}
	} else {
		sr = onRun(kb);
		if (sr.NextMenuToRun != this) {
			shutdown();
		}
	}
	return sr;
}

StateBase::~StateBase() {
}

ErrorType StateBase::init() {
	ErrorType et = onInit();
	if (et.ok()) {
		setState(INIT_BIT);
		StateStartTime = HAL_GetTick();
	}
	return et;
}
ErrorType StateBase::shutdown() {
	ErrorType et = onShutdown();
	clearState(INIT_BIT);
	StateStartTime = 0;
	return et;
}

uint32_t StateBase::timeInState() {
	return HAL_GetTick() - StateStartTime;
}

//=======================================================================
DisplayMessageState::DisplayMessageState(uint16_t timeInState, StateBase *nextState) :
		TimeInState(timeInState), NextState(nextState) {
}

DisplayMessageState::~DisplayMessageState() {
}

ErrorType DisplayMessageState::onInit() {
	return ErrorType();
}

void DisplayMessageState::setMessage(const char *msg) {
	strncpy(&this->Message[0], msg, sizeof(this->Message));
}

ReturnStateContext DisplayMessageState::onRun(QKeyboard &kb) {
	gui_lable_multiline(&this->Message[0], 0, 10, 120, 50, SSD1306_COLOR_BLACK, 0);
	if (timeInState() > TimeInState || kb.getLastKeyReleased() != QKeyboard::NO_PIN_SELECTED) {
		return ReturnStateContext(StateFactory::getMenuState());
	}
	return ReturnStateContext(this);
}

ErrorType DisplayMessageState::onShutdown() {
	return true;
}

MenuState::MenuState() :
		StateBase(), MenuList("Main Menu", Items, 0, 10, 128, 64, 0, (sizeof(Items) / sizeof(Items[0]))) {
}

MenuState::~MenuState() {

}

const char *HasMessage = "DCDN Net Msgs *";
const char *NoHasMessage = "DCDN Net Msgs";

ErrorType MenuState::onInit() {
	gui_set_curList(&MenuList);
	Items[0].id = 0;
	if (getContactStore().getSettings().isNameSet()) {
		Items[0].text = (const char *) "Settings";
	} else {
		Items[0].text = (const char *) "Settings *";
	}
	Items[1].id = 1;
	Items[1].text = (const char *) "IR Pair";
	Items[2].id = 2;
	Items[2].text = (const char *) "Address Book";
	Items[3].id = 3;
	if (StateFactory::getMessageState()->hasNewMessage()) {
		Items[3].text = HasMessage;
	} else {
		Items[3].text = NoHasMessage;
	}
	Items[4].id = 4;
	Items[4].text = (const char *) "Enigma";
	Items[5].id = 5;
	Items[5].text = (const char *) "Screen Saver";
	Items[6].id = 6;
	Items[6].text = (const char *) "Badge Info";
	Items[7].id = 7;
	Items[7].text = (const char *) "Radio Info";
	Items[8].id = 8;
	Items[8].text = "";
	//Items[7].text = (const char *) "Event Log";
	return ErrorType();
}

ReturnStateContext MenuState::onRun(QKeyboard &kb) {
	uint8_t key = kb.getLastKeyReleased();
	StateBase *nextState = this;
	switch (key) {
	case 1: {
		if (MenuList.selectedItem == 0) {
			MenuList.selectedItem = sizeof(Items) / sizeof(Items[0]) - 1;
		} else {
			MenuList.selectedItem--;
		}
		break;
	}
	case 7: {
		if (MenuList.selectedItem == (sizeof(Items) / sizeof(Items[0]) - 1)) {
			MenuList.selectedItem = 0;
		} else {
			MenuList.selectedItem++;
		}
		break;
	}
	case 9: {
		MenuList.selectedItem = 0;
	}
		break;
	case 11: {
		switch (MenuList.selectedItem) {
		case 0:
			nextState = StateFactory::getSettingState();
			break;
		case 1:
			if (getContactStore().getSettings().getAgentName()[0] != '\0') {
				nextState = StateFactory::getIRPairingState();
			} else {
				nextState = StateFactory::getDisplayMessageState(StateFactory::getMenuState(),
						(const char *) "You must set your agent name first", 3000);
			}
			break;
		case 2:
			nextState = StateFactory::getAddressBookState();
			break;
		case 3:
			nextState = StateFactory::getMessageState();
			break;
		case 4:
			nextState = StateFactory::getEnigmaState();
			break;
		case 5:
			nextState = StateFactory::getGameOfLifeState();
			break;
		case 6:
			nextState = StateFactory::getBadgeInfoState();
			break;
		case 7:
			nextState = StateFactory::getRadioInfoState();
			break;
			//case 8:
			//	nextState = StateFactory::getEventState();
			//	break;
		}
	}
		break;
	}
	return ReturnStateContext(nextState);
}

ErrorType MenuState::onShutdown() {
	gui_set_curList(0);
	MenuList.selectedItem = 0;
	return ErrorType();
}

SettingState::SettingState() :
		StateBase(), SettingList((const char *) "MENU", Items, 0, 0, 128, 64, 0, sizeof(Items) / sizeof(Items[0])), InputPos(
				0), SubState(0) {

	memset(&AgentName[0], 0, sizeof(AgentName));
	Items[0].id = 0;
	Items[0].text = (const char *) "Set Agent Name";
	Items[1].id = 1;
	//Items[1].text = (const char *) "Set Screen Saver";
	//Items[2].id = 2;
	Items[1].text = (const char *) "Set Screen Saver Time";
	Items[1].setShouldScroll();
	Items[2].id = 3;
	Items[2].text = (const char *) "Reset Badge Contacts";
	Items[2].setShouldScroll();
}

SettingState::~SettingState() {

}

ErrorType SettingState::onInit() {
	gui_set_curList(&SettingList);
	SubState = 0;
	return ErrorType();
}

static const char *NUMBERS = "123456789";

ReturnStateContext SettingState::onRun(QKeyboard & kb) {
	uint8_t key = kb.getLastKeyReleased();
	StateBase *nextState = this;
	switch (SubState) {
	case 0:
		switch (key) {
		case 1: {
			if (SettingList.selectedItem == 0) {
				SettingList.selectedItem = sizeof(Items) / sizeof(Items[0]) - 1;
			} else {
				SettingList.selectedItem--;
			}
			break;
		}
		case 7: {
			if (SettingList.selectedItem == (sizeof(Items) / sizeof(Items[0]) - 1)) {
				SettingList.selectedItem = 0;
			} else {
				SettingList.selectedItem++;
			}
			break;
		}
		case 9: {
			nextState = StateFactory::getMenuState();
		}
			break;
		case 11: {
			SubState = SettingList.selectedItem + 100;
			gui_set_curList(0);
			gui_draw();
			switch (SubState) {
			case 100:
				memset(&AgentName[0], 0, sizeof(AgentName));
				getKeyboardContext().init(&AgentName[0], sizeof(AgentName));
				break;
				//case 101:
				//	sprintf(&AgentName[0], "Current:  %d", getContactStore().getSettings().getScreenSaverType() + 1);
				//	break;
			case 101:
				InputPos = getContactStore().getSettings().getScreenSaverTime();
				break;
			case 102:
				kb.reset();
				break;
			}
		}
			break;
		default:
			break;
		}
		break;
	case 100: {
		gui_lable_multiline((const char*) "Current agent name:", 0, 10, 128, 64, 0, 0);
		if (*getContactStore().getSettings().getAgentName() == '\0') {
			gui_lable_multiline((const char *) "NOT SET", 0, 20, 128, 64, 0, 0);
		} else {
			gui_lable_multiline(getContactStore().getSettings().getAgentName(), 0, 20, 128, 64, 0, 0);
		}
		gui_lable_multiline((const char*) "Set agent name:", 0, 30, 128, 64, 0, 0);
		kb.updateContext(getKeyboardContext());
		if (kb.getLastKeyReleased() == 11 && AgentName[0] != '\0' && AgentName[0] != ' ' && AgentName[0] != '_') {
			AgentName[ContactStore::AGENT_NAME_LENGTH - 1] = '\0';
			getKeyboardContext().finalize();
			//done
			if (getContactStore().getSettings().setAgentname(&AgentName[0])) {
				nextState = StateFactory::getDisplayMessageState(StateFactory::getMenuState(), "Save Successful", 2000);
			} else {
				nextState = StateFactory::getDisplayMessageState(StateFactory::getMenuState(), "Save FAILED!", 4000);
			}
		} else {
			gui_lable_multiline(&AgentName[0], 0, 40, 128, 64, 0, 0);
		}
		break;
	}
		/*
		 case 101: {
		 gui_lable_multiline((const char*) "Screen Saver:", 0, 10, 128, 64, 0, 0);
		 gui_lable_multiline(&AgentName[0], 0, 20, 128, 64, 0, 0);
		 gui_lable_multiline((const char*) "1: Game of Life", 0, 30, 128, 64, 0, 0);
		 uint8_t ss = kb.getLastKeyReleased();
		 switch (ss) {
		 case 0:
		 if (getContactStore().getSettings().setScreenSaverType(ss)) {
		 nextState = StateFactory::getDisplayMessageState(StateFactory::getMenuState(), "Setting saved", 2000);
		 } else {
		 nextState = StateFactory::getDisplayMessageState(StateFactory::getMenuState(), "Save FAILED!", 4000);
		 }
		 break;
		 }
		 break;
		 }
		 */
	case 101:
		gui_lable_multiline((const char*) "Time until badge\ngoes to sleep:", 0, 10, 128, 64, 0, 0);
		if (kb.getLastKeyReleased() == 9 || kb.getLastKeyReleased() == 10
				|| kb.getLastKeyReleased() == QKeyboard::NO_PIN_SELECTED) {
			//InputPos = 4;
		} else if (kb.getLastKeyReleased() == 11) {
			if (getContactStore().getSettings().setScreenSaverTime(InputPos)) {
				nextState = StateFactory::getDisplayMessageState(StateFactory::getMenuState(), "Setting saved", 2000);
			} else {
				nextState = StateFactory::getDisplayMessageState(StateFactory::getMenuState(), "Save FAILED!", 4000);
			}
		} else {
			InputPos = kb.getLastKeyReleased();
			if (InputPos > 8) {
				InputPos = 8;
			}
		}
		sprintf(&AgentName[0], "%c Minutes", NUMBERS[InputPos]);
		gui_lable_multiline(&AgentName[0], 0, 40, 128, 64, 0, 0);
		break;
	case 102:
		gui_lable_multiline((const char*) "ERASE ALL\nCONTACTS?", 0, 10, 128, 64, 0, 0);
		gui_lable_multiline((const char*) "Press # to Cancel", 0, 30, 128, 64, 0, 0);
		gui_lable_multiline((const char*) "Press enter to do it", 0, 40, 128, 64, 0, 0);
		if (kb.getLastKeyReleased() == 9) {
			nextState = StateFactory::getMenuState();
		} else if (kb.getLastKeyReleased() == 11) {
			getContactStore().resetToFactory();
			StateFactory::getAddressBookState()->resetSelection();
			nextState = StateFactory::getMenuState();
		}
		break;
	}
	return ReturnStateContext(nextState);
}

ErrorType SettingState::onShutdown() {
	InputPos = 0;
	gui_set_curList(0);
	memset(&AgentName[0], 0, sizeof(AgentName));
	return ErrorType();
}

/////////////////////////////////////////////////////////////////////////////////////////////////////

//////////////////////////////////////////////////////////////

BadgeInfoState::BadgeInfoState() :
		StateBase(), BadgeInfoList("Badge Info:", Items, 0, 0, 128, 64, 0, (sizeof(Items) / sizeof(Items[0]))), RegCode() {

	memset(&RegCode, 0, sizeof(RegCode));
}

BadgeInfoState::~BadgeInfoState() {

}

const char *BadgeInfoState::getRegCode() {
	if (RegCode[0] == 0) {
		ShaOBJ hashObj;
		sha256_init(&hashObj);
		//const char *p = "this is my message";
		//sha256_add(&hashObj,(const uint8_t*)p,strlen(p));
		sha256_add(&hashObj, getContactStore().getMyInfo().getPrivateKey(), ContactStore::PRIVATE_KEY_LENGTH);
		uint16_t id = getContactStore().getMyInfo().getUniqueID();
		sha256_add(&hashObj, (uint8_t *) &id, sizeof(id));
		uint8_t rH[SHA256_HASH_SIZE];
		sha256_digest(&hashObj, &rH[0]);
		sprintf(&RegCode[0], "%02x%02x%02x%02x%02x%02x%02x%02x", rH[0], rH[1], rH[2], rH[3], rH[4], rH[5], rH[6],
				rH[7]);
	}
	return &RegCode[0];
}

static const char *VERSION = "dc24.1.1";

ErrorType BadgeInfoState::onInit() {
	gui_set_curList(&BadgeInfoList);
	memset(&ListBuffer[0], 0, sizeof(ListBuffer));
	sprintf(&ListBuffer[0][0], "N: %s", getContactStore().getSettings().getAgentName());
	sprintf(&ListBuffer[1][0], "Num contacts: %u", getContactStore().getSettings().getNumContacts());
	sprintf(&ListBuffer[2][0], "REG: %s", getRegCode());
	sprintf(&ListBuffer[3][0], "UID: %u", getContactStore().getMyInfo().getUniqueID());
	uint8_t *pCP = getContactStore().getMyInfo().getCompressedPublicKey();
	sprintf(&ListBuffer[4][0],
			"PK: %02x%02x%02x%02x%02x%02x%02x%02x%02x%02x%02x%02x%02x%02x%02x%02x%02x%02x%02x%02x%02x%02x%02x%02x%02x",
			pCP[0], pCP[1], pCP[2], pCP[3], pCP[4], pCP[5], pCP[6], pCP[7], pCP[8], pCP[9], pCP[10], pCP[11], pCP[12],
			pCP[13], pCP[14], pCP[15], pCP[16], pCP[17], pCP[18], pCP[19], pCP[20], pCP[21], pCP[22], pCP[23], pCP[24]);
	sprintf(&ListBuffer[5][0], "DEVID: %lu", HAL_GetDEVID());
	sprintf(&ListBuffer[6][0], "REVID: %lu", HAL_GetREVID());
	sprintf(&ListBuffer[7][0], "HAL Version: %lu", HAL_GetHalVersion());
	sprintf(&ListBuffer[8][0], "SVer: %s", VERSION);
	for (uint32_t i = 0; i < (sizeof(Items) / sizeof(Items[0])); i++) {
		Items[i].text = &ListBuffer[i][0];
		Items[i].id = i;
		Items[i].setShouldScroll();
	}
	return ErrorType();
}

ReturnStateContext BadgeInfoState::onRun(QKeyboard &kb) {
	uint8_t key = kb.getLastKeyReleased();
	StateBase *nextState = this;
	switch (key) {
	case 1: {
		if (BadgeInfoList.selectedItem == 0) {
			BadgeInfoList.selectedItem = sizeof(Items) / sizeof(Items[0]) - 1;
		} else {
			BadgeInfoList.selectedItem--;
		}
		break;
	}
	case 7: {
		if (BadgeInfoList.selectedItem == (sizeof(Items) / sizeof(Items[0]) - 1)) {
			BadgeInfoList.selectedItem = 0;
		} else {
			BadgeInfoList.selectedItem++;
		}
		break;
	}
	case 9: {
		nextState = StateFactory::getMenuState();
	}
		break;
	}
	return ReturnStateContext(nextState);
}

ErrorType BadgeInfoState::onShutdown() {
	gui_set_curList(0);
	return ErrorType();
}

////////////////////////////////////////////////////////////////////////////////////////////////////

RadioInfoState::RadioInfoState() :
		StateBase(), RadioInfoList("Radio Info:", Items, 0, 0, 128, 64, 0, (sizeof(Items) / sizeof(Items[0]))), Items(), ListBuffer() {

}

RadioInfoState::~RadioInfoState() {

}

ErrorType RadioInfoState::onInit() {
	gui_set_curList(&RadioInfoList);
	memset(&ListBuffer[0], 0, sizeof(ListBuffer));
	for (uint32_t i = 0; i < (sizeof(Items) / sizeof(Items[0])); i++) {
		Items[i].text = &ListBuffer[i][0];
	}
	return ErrorType();
}

ReturnStateContext RadioInfoState::onRun(QKeyboard &kb) {
	StateBase *nextState = this;
	sprintf(&ListBuffer[0][0], "Frequency: %lu", getRadio().getFrequency());
	sprintf(&ListBuffer[1][0], "RSSI: %d", getRadio().readRSSI());
	sprintf(&ListBuffer[2][0], "RSSI Threshold: %u", getRadio().getRSSIThreshHold());
	sprintf(&ListBuffer[3][0], "Gain: %u", getRadio().getCurrentGain());
	sprintf(&ListBuffer[4][0], "Temp: %u", getRadio().readTemperature());
	uint8_t pin = kb.getLastKeyReleased();
	if (pin == 9) {
		nextState = StateFactory::getMenuState();
	}
	return ReturnStateContext(nextState);
}

ErrorType RadioInfoState::onShutdown() {
	gui_set_curList(0);
	return ErrorType();
}

//============================================================
DisplayMessageState Display_Message_State(3000, 0);
MenuState MenuState;
IRState TheIRPairingState(2000, 5);
SettingState TheSettingState;
EngimaState TheEnginmaState;
AddressState TheAddressState;
SendMsgState TheSendMsgState;
RadioInfoState TheRadioInfoState;
BadgeInfoState TheBadgeInfoState;
GameOfLife TheGameOfLifeState;
MessageState TheMessageState;
//EventState TheEventState;

bool StateFactory::init() {
	return true;
}

StateBase *StateFactory::getDisplayMessageState(StateBase *bm, const char *message, uint16_t timeToDisplay) {
	Display_Message_State.setMessage(message);
	Display_Message_State.setNextState(bm);
	Display_Message_State.setTimeInState(timeToDisplay);
	return &Display_Message_State;
}

StateBase * StateFactory::getMenuState() {
	return &MenuState;
}

StateBase *StateFactory::getSettingState() {
	return &TheSettingState;
}

IRState *StateFactory::getIRPairingState() {
	return &TheIRPairingState;
}

AddressState *StateFactory::getAddressBookState() {
	return &TheAddressState;
}

SendMsgState *StateFactory::getSendMessageState() {
	return &TheSendMsgState;
}

StateBase*StateFactory::getEnigmaState() {
	return &TheEnginmaState;
}

StateBase* StateFactory::getBadgeInfoState() {
	return &TheBadgeInfoState;
}

StateBase* StateFactory::getRadioInfoState() {
	return &TheRadioInfoState;
}

StateBase *StateFactory::getGameOfLifeState() {
	return &TheGameOfLifeState;
}

MessageState *StateFactory::getMessageState() {
	return &TheMessageState;
}
/*
 EventState *StateFactory::getEventState() {
 return &TheEventState;
 }
 */
