thedarknet/defcon24/(commit log)

2016-05-23 using project with correct mcu - stm32f103c8t6 as it matters when saving to flash
    [HardwareSPI.cpp, HardwareSPI.h, KeyStore.cpp, KeyStore.h, Keyboard.cpp, Keyboard.h, badge-firmware.ioc, badge.cpp]
2016-05-23 removing project for wrong mcu - wrong one is stm32f103cbt6 nor stm32f103c8t6
    [HardwareSPI.cpp, HardwareSPI.h, KeyStore.cpp, KeyStore.h, Keyboard.cpp, Keyboard.h, badge.cpp, badge.h]
2016-05-27 test code for timer now works updated comments in keystore to reflect what we need for the contest removed test code from keyboard::scan
2016-06-17 Keyboard working and some commented out code about LEDs.
2016-06-26 Added board files
    [DC24-Darknet_Badge.brd, DC24-Darknet_Badge.sch]
2016-07-07 working on device - display code is working
2016-07-07 fixed bugs in internal dispatch of StateBase
    [badge.cpp, badge.h, menus.cpp]
2016-07-10 fixed bogus compiler error, bogus because the application did link
    [main.cpp]
2016-07-15 removed the use of uart2 in prep for Alvaro's changes
2016-07-17 updated enigma encryption to work with 13 rotors and plugboard configs stopped clearing display buffer so we can show logo
2016-07-17 Added finial board versions. Base and shield have most recent changes. Main file has entire circuit.
    [DC24-Darknet_Badge-base.brd, DC24-Darknet_Badge-base.sch, DC24-Darknet_Badge-shield.brd, DC24-Darknet_Badge-shield.sch, DC24-Darknet_Badge.brd]
2016-07-17 fixes a number of bugs, found but not fixed yet a bug in gui_lable that does not exist in the multi line version of the same fuction. Work on keyboard is started
    [Keyboard.cpp, Keyboard.h, RFM69.cpp, badge.cpp, menus.cpp, menus.h]
2016-07-17 moved board files over so we don't lose them
    [DC24-Darknet_Badge-base.brd, DC24-Darknet_Badge-base.sch, DC24-Darknet_Badge-shield.brd, DC24-Darknet_Badge-shield.sch, DC24-Darknet_Badge.brd]
2016-07-18 folded in Alvaro's IR code not working just added
    [badge.cpp, ir.cpp, ir.h, irmenu.cpp, irmenu.h, menus.cpp, menus.h]
2016-07-25 removed usb virtual serial device...we just don't have enough flash to fit it all
2016-07-27 fixed 1 more keyboard bug enigma state if complete
    [EngimaState.cpp, EnigmaState.h, Keyboard.cpp, Keyboard.h, badge.cpp, menus.cpp, menus.h]
2016-08-01 fixed but with circular buffer handling in DCDarkNetMsg state
    [MessageState.cpp, MessageState.h]
2016-08-02 adding back correct hash inputs again
    [menus.cpp]
2016-08-02 Fix: screen saver bug timing issue Updated enimga to scroll on both entry and final display. Fixed bug where you would not see the code to send to the daemon.
    [EngimaState.cpp, EnigmaState.h, badge.cpp]
2016-08-03 fixing not saving all the data for pairing signature
    [KeyStore.cpp]
2016-08-03 fixed display issue with reg code
    [menus.cpp, menus.h]
2016-08-03 fixed bug introduced last nigh
    [SendMsgState.cpp]
2016-08-04 LED now blinks for new message
2016-08-04 many many many bug fixes
    [AddressState.cpp, AddressState.h, KeyStore.cpp, KeyStore.h, badge.cpp, irmenu.cpp, main.cpp, menus.cpp]
2016-08-04 fixed bug with saving paring code
    [KeyStore.cpp]
2016-08-05 fixed a number of address book erros in the flash storage code and the display code
    [AddressState.cpp, AddressState.h, KeyStore.cpp, KeyStore.h, main.cpp, menus.cpp, menus.h]
2016-08-06 fixed agent name overflow
    [Keyboard.cpp]
2016-08-06 fixed boss hd quest
    [main.cpp]
2016-08-08 Board design that was made for DEF CON Note there are some problems with ground plane isolation that were not caught which makes this easy to accidentally bridge VCC and GND when soldering.
    [DC24-Darknet_Badge-base.brd, DC24-Darknet_Badge-shield.brd]
2016-08-08 Added bill of materials export from google docs
2016-08-10 Updated base board to provide more isolation on the ground plane
    [DC24-Darknet_Badge-base.brd, DC24-Darknet_Badge-base.sch]
2016-08-13 added notes on making the boards through osh park
2016-08-16 Update part numbers. Had incorrect part number on SMD resistor.
2016-08-26 Updated description for SMD resistor, and added OSH Park project links
