thedarknet/defcon24/(notices)

Notices in the files:
badge/badge-firmware-eclipse/src/Radio/RFM69registers.h:
Copyright Felix Rusu (2015), felix@lowpowerlab.com
Public License as published by the Free Software
Public License along with this program; if not, write
badge/badge-firmware-eclipse/src/Radio/RFM69.h:
Copyright Felix Rusu (2014), felix@lowpowerlab.com
Public License along with this program.
